MalekAlbdoor/UNCC_ROCKETRY_PAYLOAD_FALL_2026/PARTS_LIST.txt

================================================================================
TRANSONIC AVIONICS PAYLOAD - MAIN ICs & SENSORS  (rev B, 2026-10-20)
================================================================================

1. CORE LOGIC & MEMORY
--------------------------------------------------------------------------------
- Microcontroller:       STM32F405RGT6 (LQFP-64, Cortex-M4 @ 168 MHz)
- Flash:                 Winbond W25Q512JVFIQ (64 MB NOR, SOIC-16 300mil)

2. SENSORS
--------------------------------------------------------------------------------
- 6-DOF IMU:             STMicroelectronics LSM6DSO32TR (±32g / ±2000 dps, LGA-14)
- High-G Accelerometer:  STMicroelectronics H3LIS331DLTR (±100/200/400g, LGA-16)
- Barometer:             TE MS561101BA03-50 (24-bit, 8-SMD)
- GPS:                   u-blox SAM-M10Q-00B (integrated antenna, LGA-20)
- Air Temp / Humidity:   Sensirion SHT45-AD1F-R2 (PTFE membrane, DFN-4)

3. TELEMETRY
--------------------------------------------------------------------------------
- Radio:                 CDEBYTE E22-900M30S (SX1262 + PA, 915 MHz, 1W)

4. CAMERA
--------------------------------------------------------------------------------
- Camera:                RunCam Split 4 V3 (4K30, 5V rail, 450 mA max, UART control)

5. POWER
--------------------------------------------------------------------------------
- 5V Buck:               TI TPS54302DDCR (3A, SOT-23-6)
- 3.3V LDO:              Diodes Inc AP2112K-3.3TRG1 (600 mA, SOT-23-5)
================================================================================
