MalekAlbdoor/UNCC_ROCKETRY_PAYLOAD_FALL_2026/Schematic.pdf

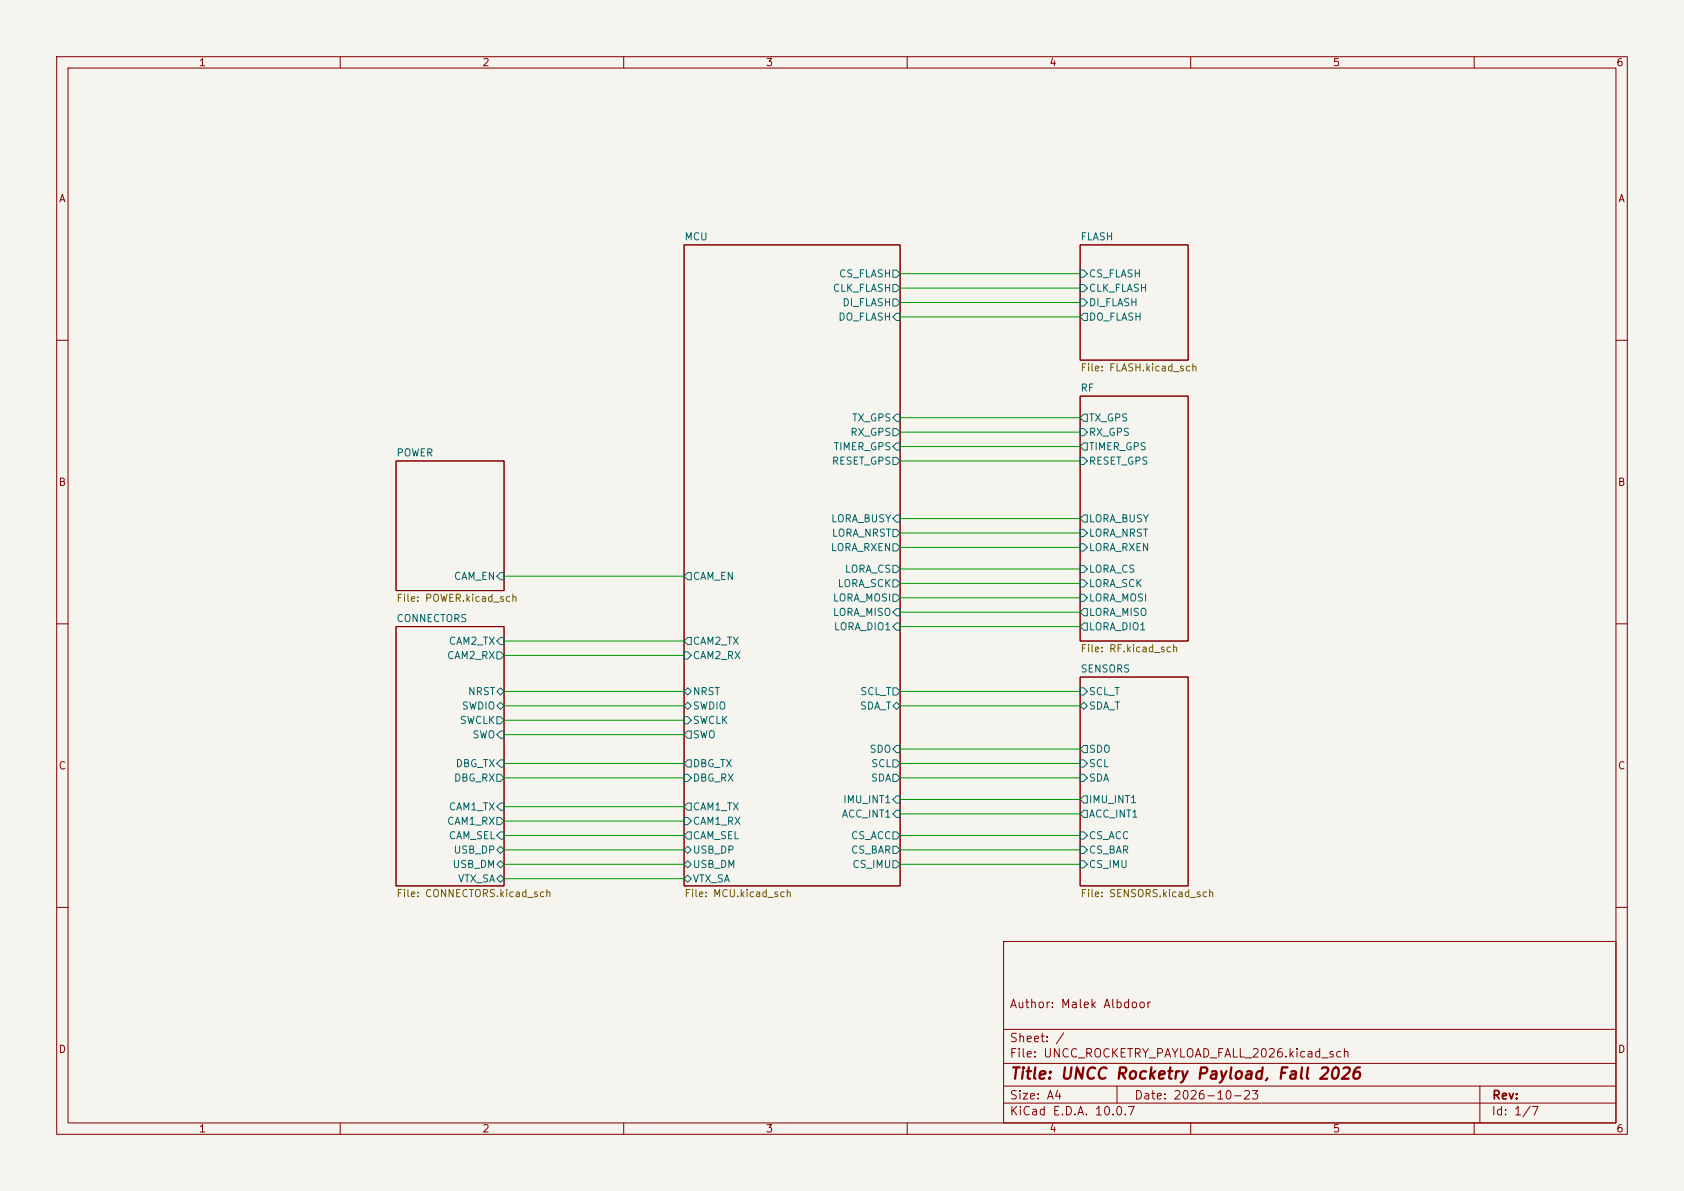
[picture p1: page 1]

File: RF.kicad_sch SCL SDA

File: MCU.kicad_sch NRST SWDIO

Sheet: /
File: UNCC_ROCKETRY_PAYLOAD_FALL_2026.kicad_sch
Title: UNCC Rocketry Payload, Fall 2026

Size: A4 | Rev:
KiCad E.D.A. 10.0.7 | Id: 1/7

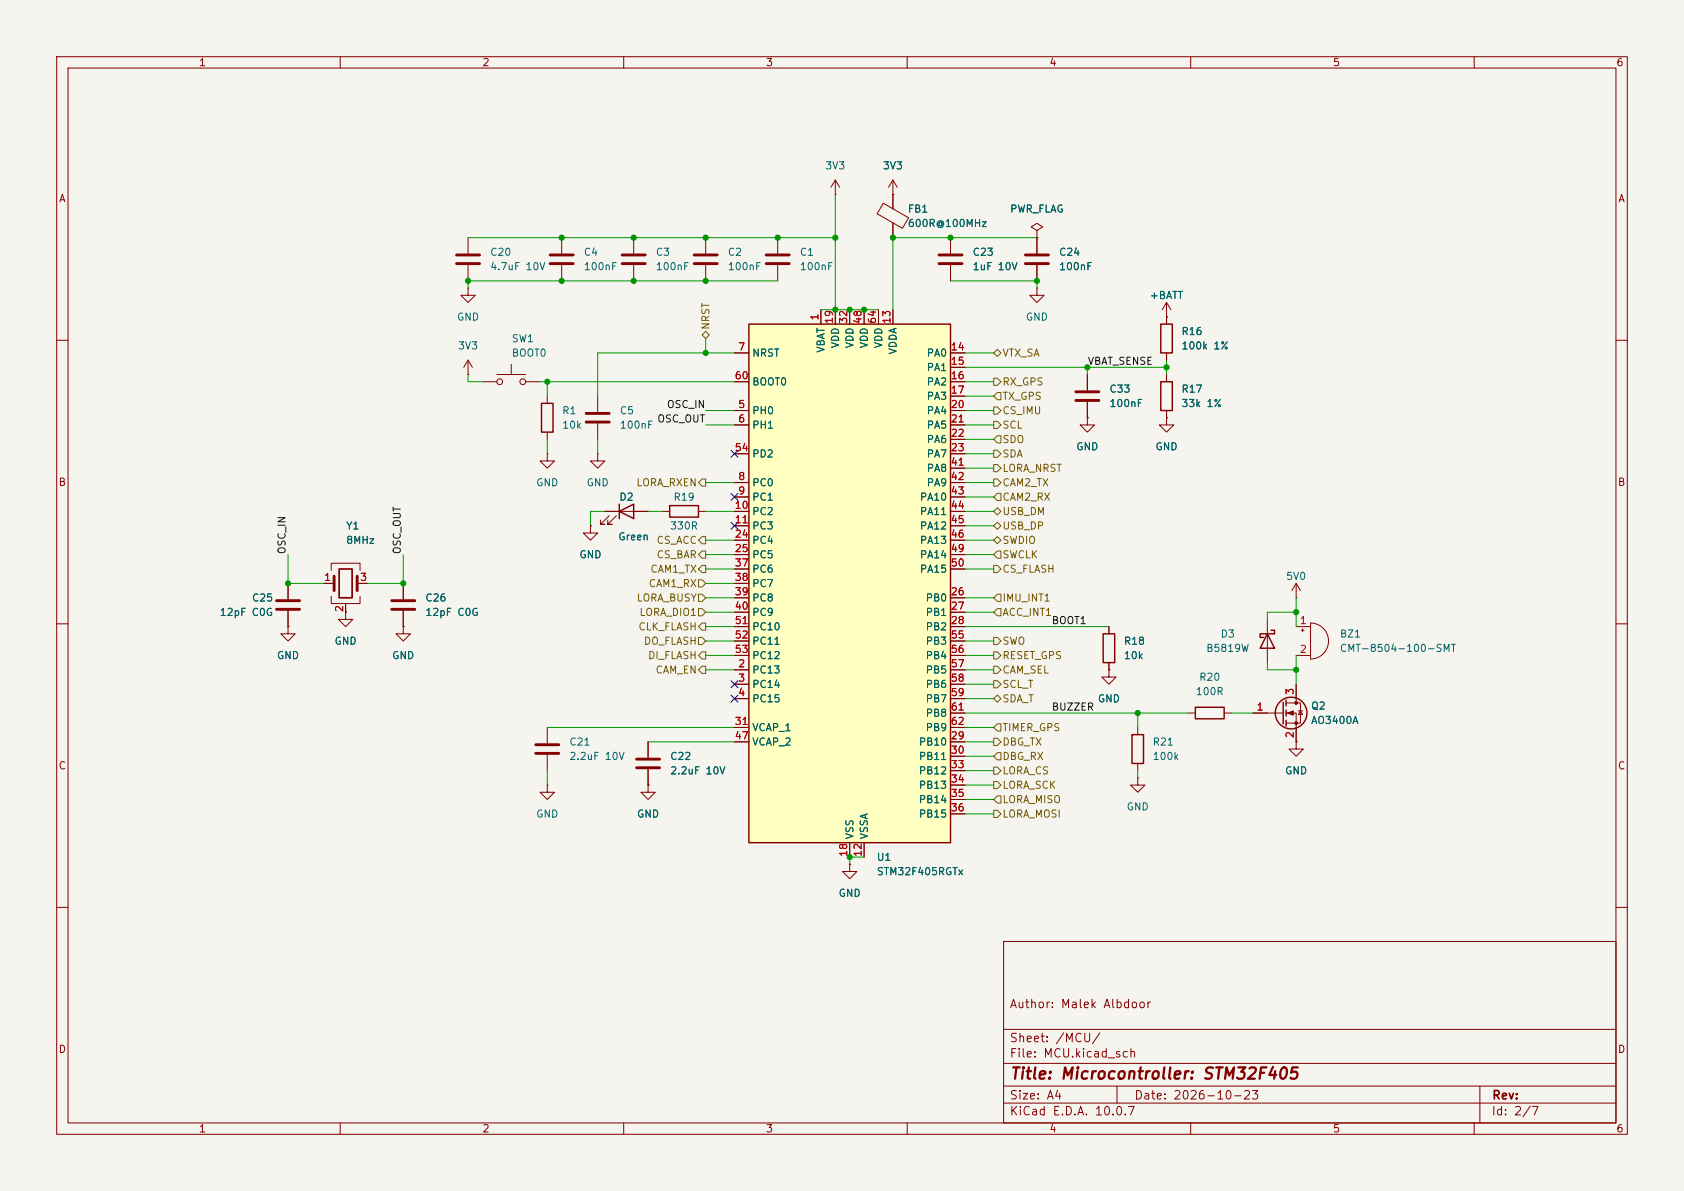
[picture p2: page 2]

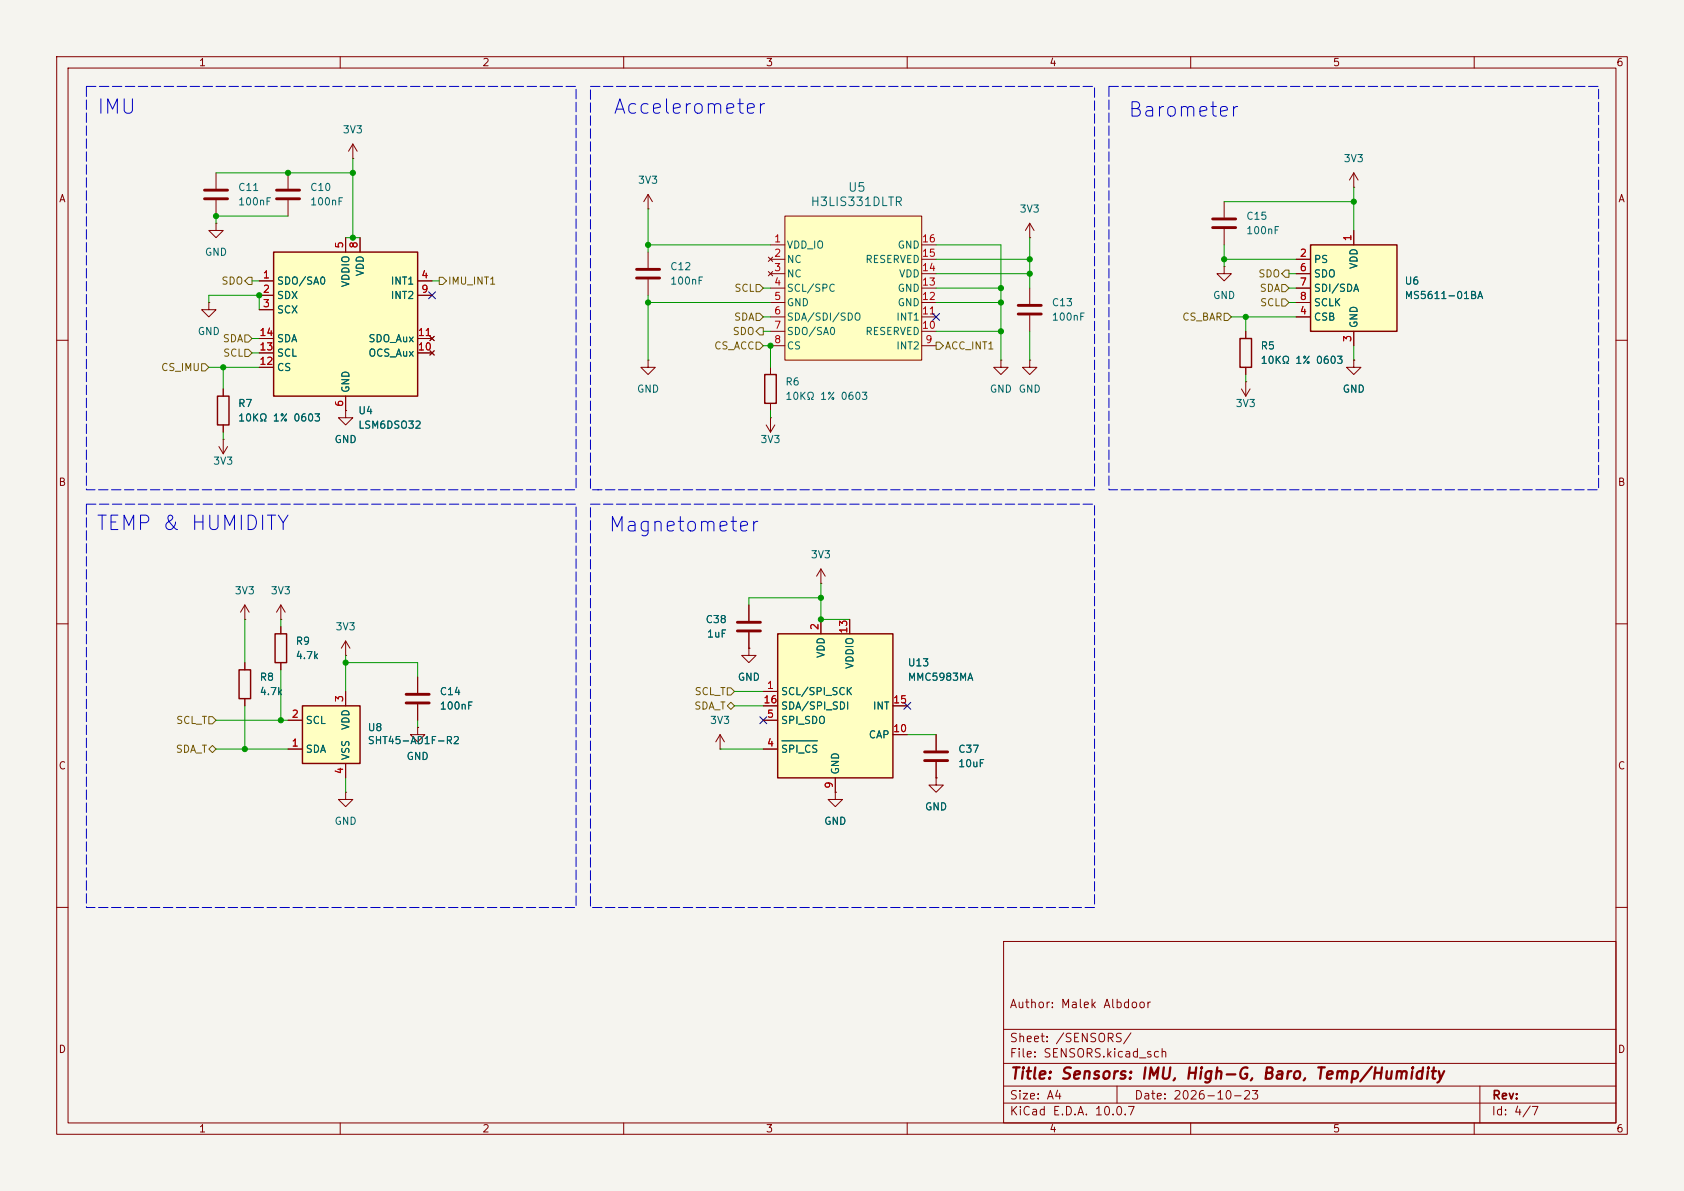
[picture p3: page 3]

Author: Malek Albdoor GND

Sheet: /SENSORS/
File: SENSORS.kicad_sch
Title: Sensors: IMU, High-G, Baro, Temp/Humidity

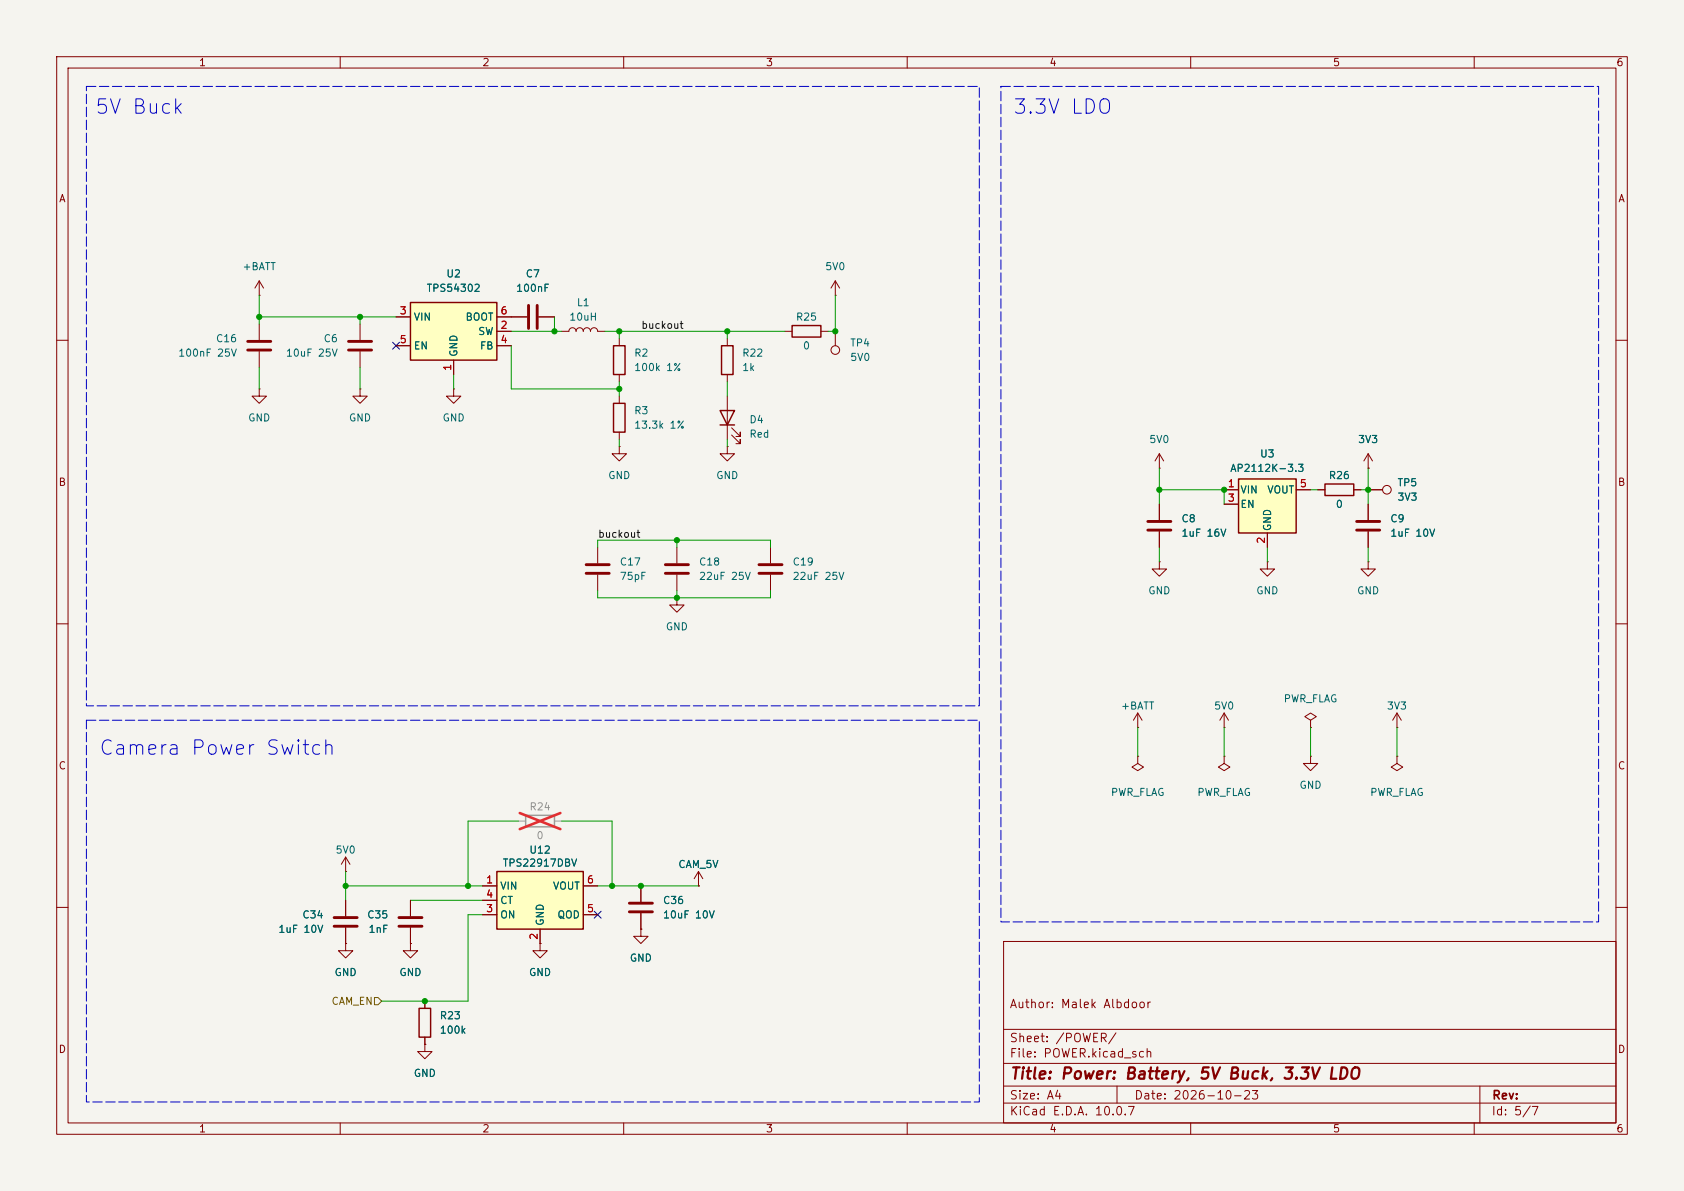
[picture p4: page 4]

Sheet: /POWER/
File: POWER.kicad_sch
Title: Power: Battery, 5V Buck, 3.3V LDO

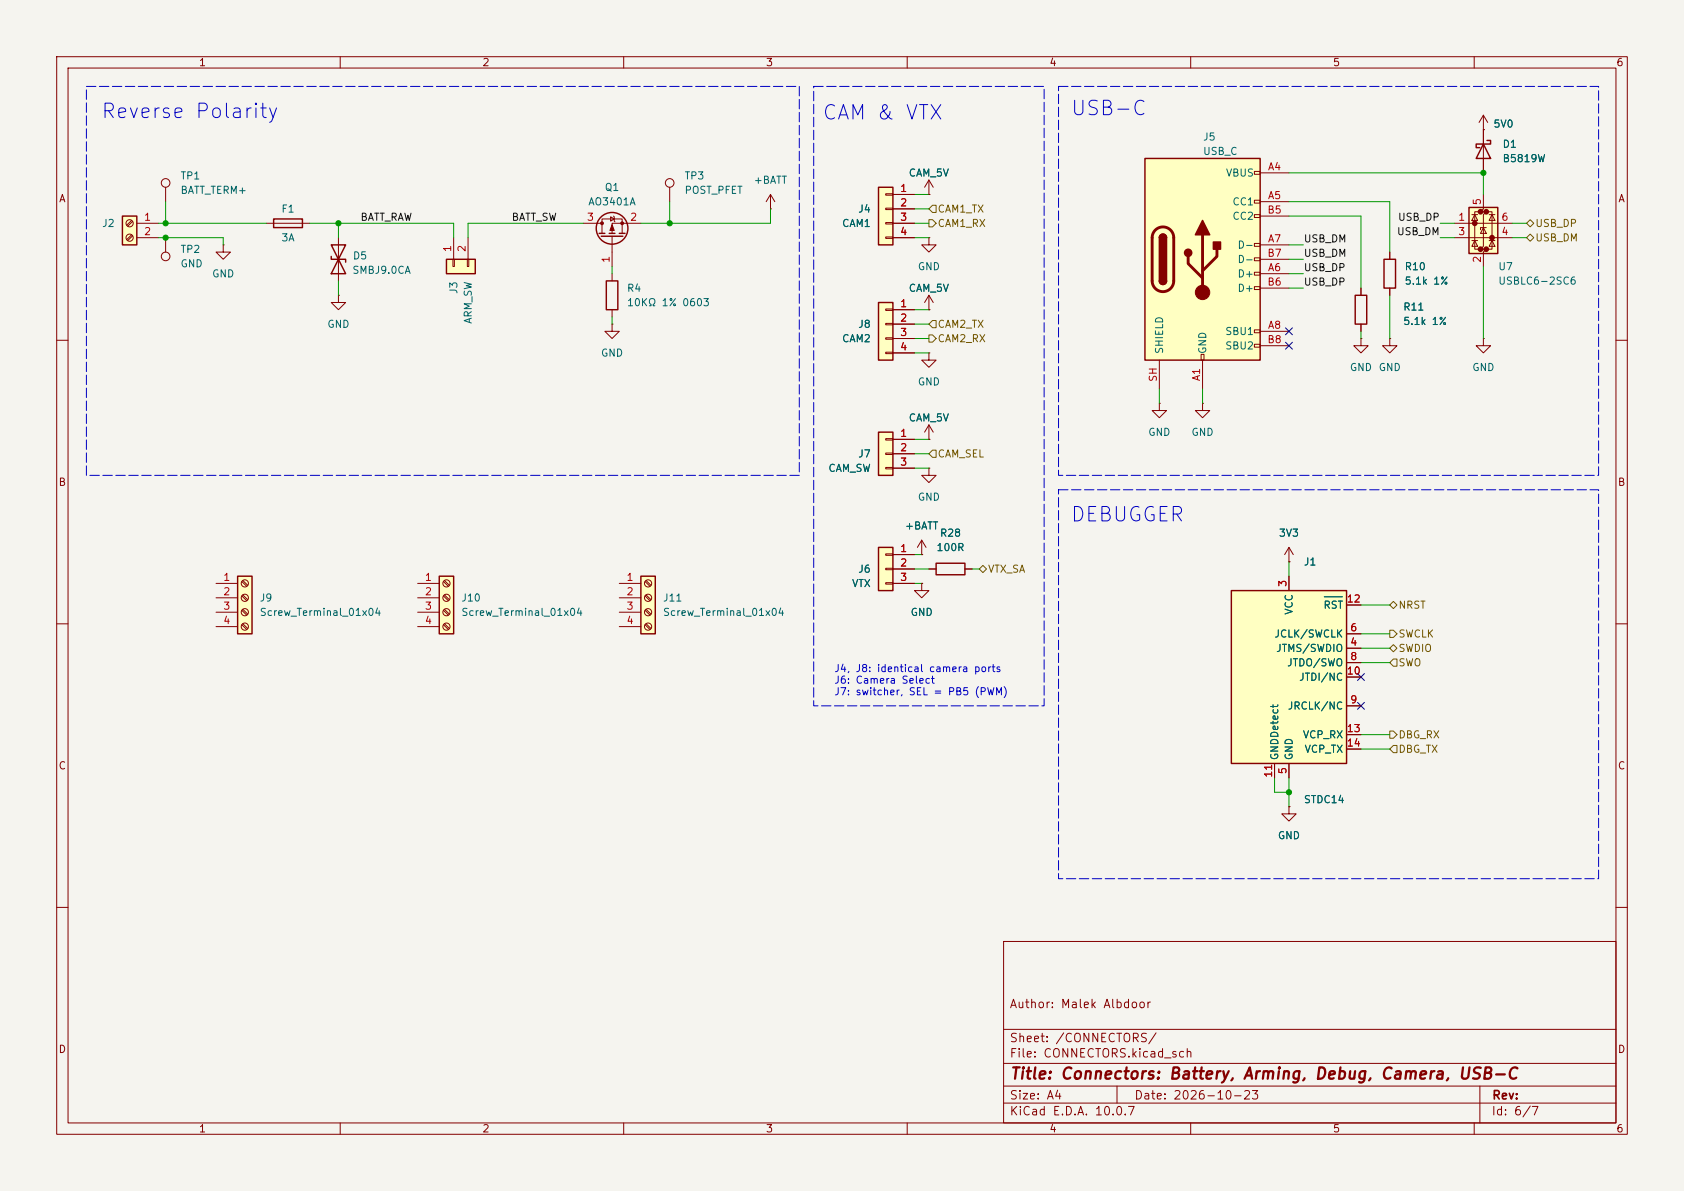
[picture p5: page 5]

J4, J8: identical camera ports
J6: Camera Select J7: switcher, SEL = PB5 (PWM)

Sheet: /CONNECTORS/
File: CONNECTORS.kicad_sch
Title: Connectors: Battery, Arming, Debug, Camera, USB-C

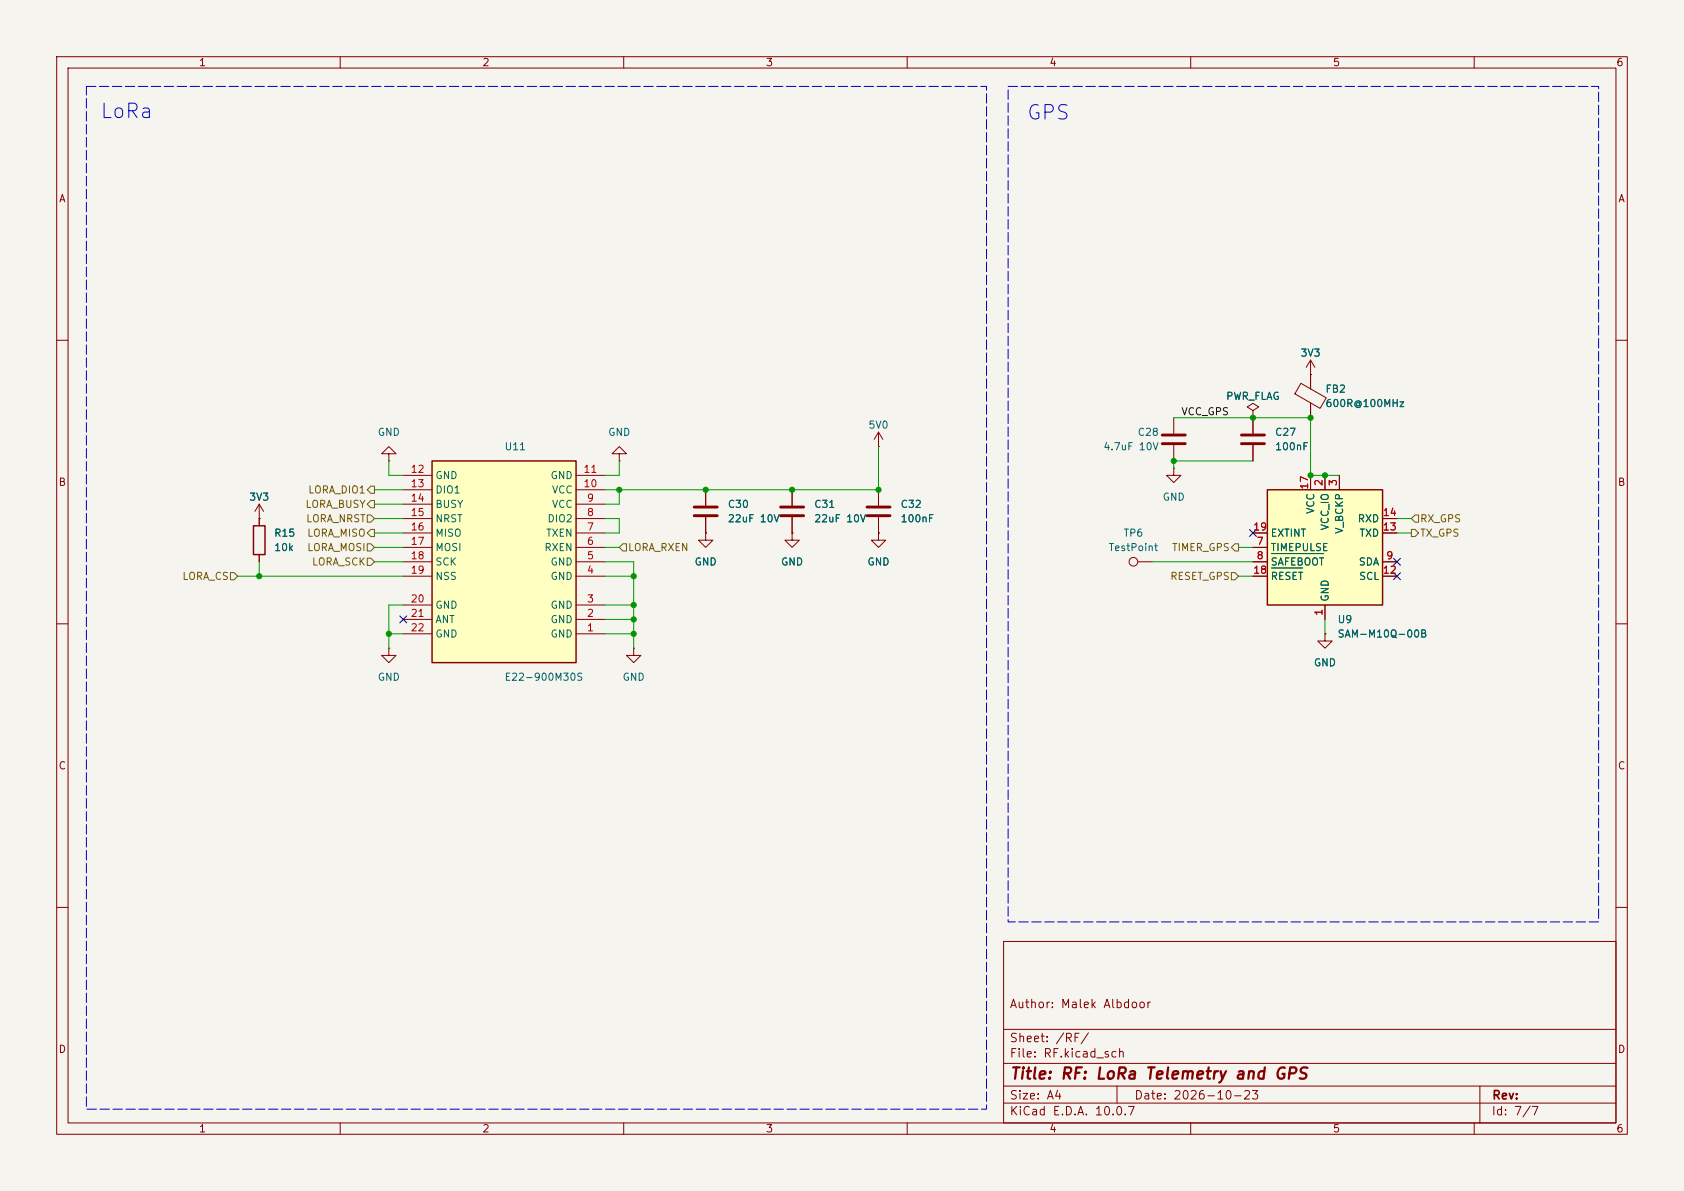
[picture p6: page 6]

Sheet: /RF/
File: RF.kicad_sch
Title: RF: LoRa Telemetry and GPS

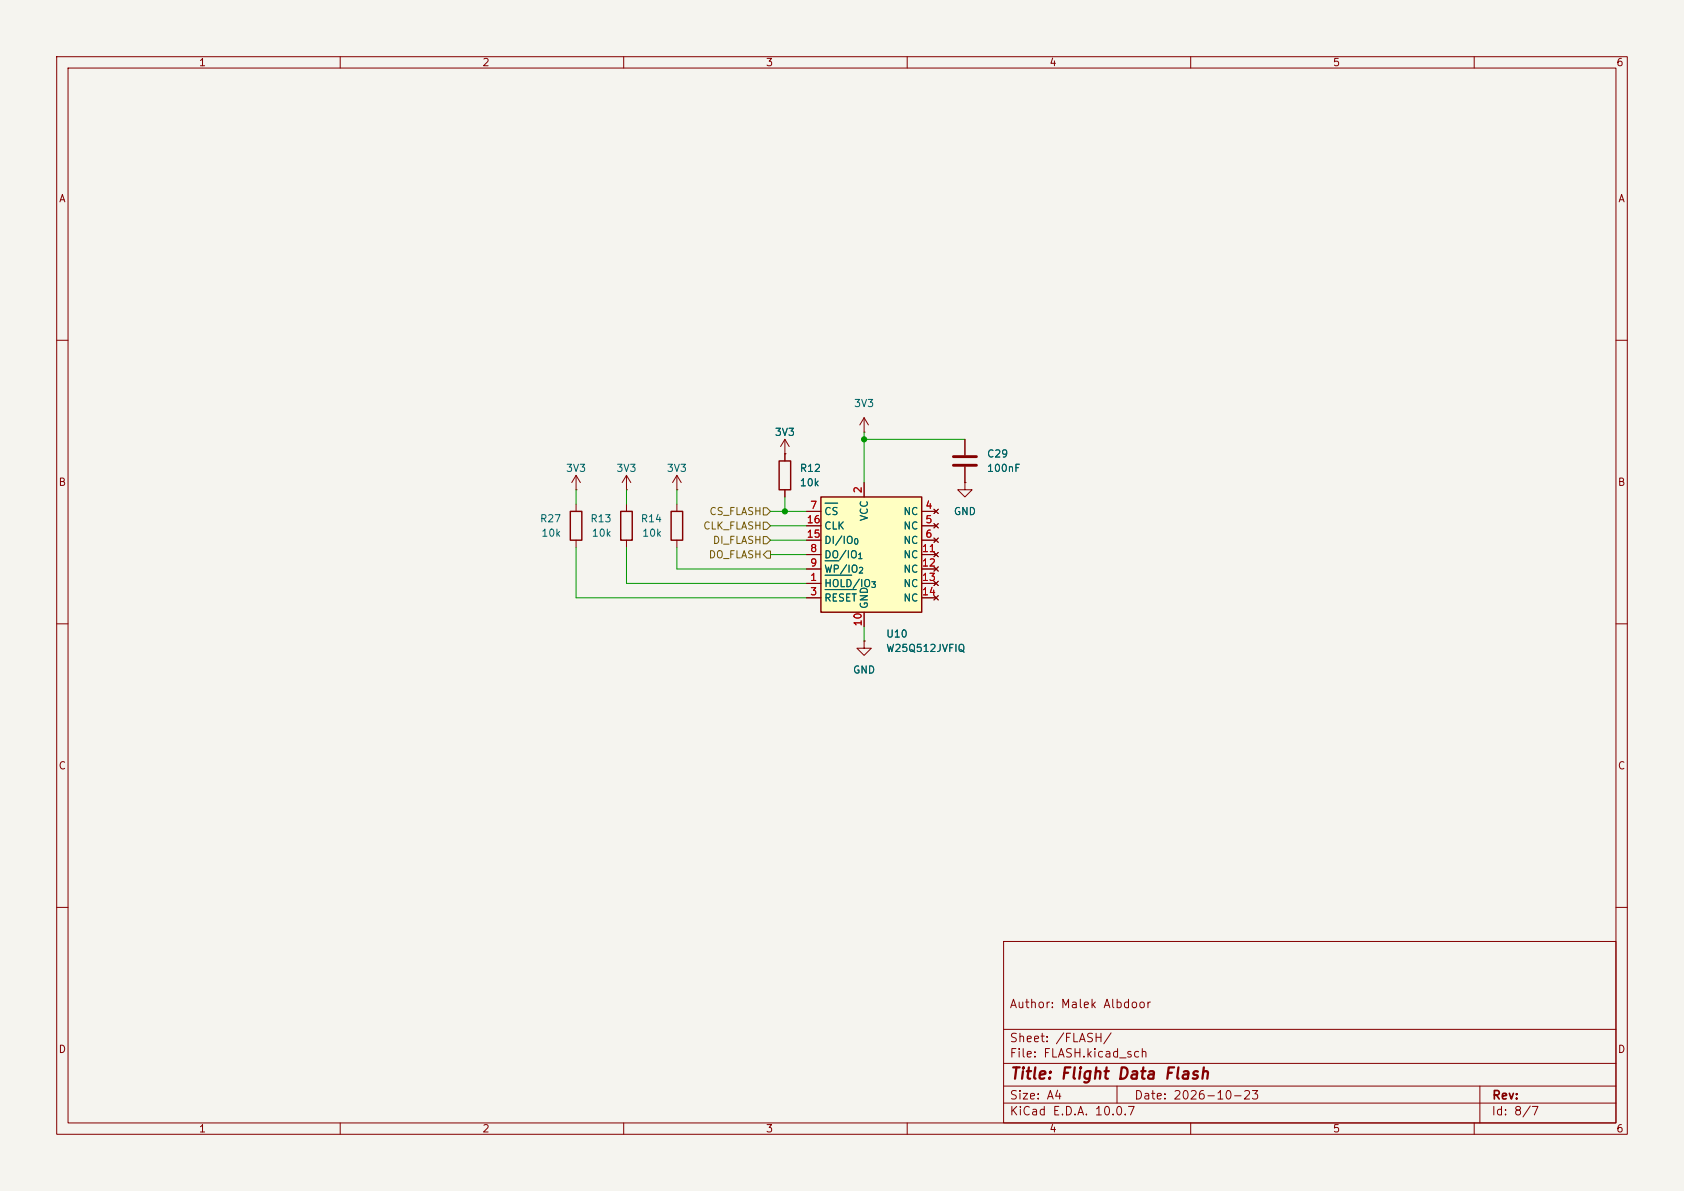
[picture p7: page 7]

Author: Malek Albdoor GND

2 RESET 3 NC 4 NC 5 NC 6 CS 7 DO/IO1 8 WP/IO2 9 GND 10 NC 11 NC 12 NC 13 NC 14 DI/IO0 15 CLK 16 U10 W25Q512JVFIQ

2 RESET 3 NC 4 NC 5 NC 6 CS 7 DO/IO1 8 WP/IO2 9 GND 10 NC 11 NC 12 NC 13 NC 14 DI/IO0 15 CLK 16 GND

Sheet: /FLASH/
File: FLASH.kicad_sch
Title: Flight Data Flash
