MalekAlbdoor/UNCC_ROCKETRY_PAYLOAD_FALL_2026/UNCC_ROCKETRY_PAYLOAD_FALL_2026.kicad_pcb

## KiCad design UNCC_ROCKETRY_PAYLOAD_FALL_2026.kicad_pcb (2026-11-13)

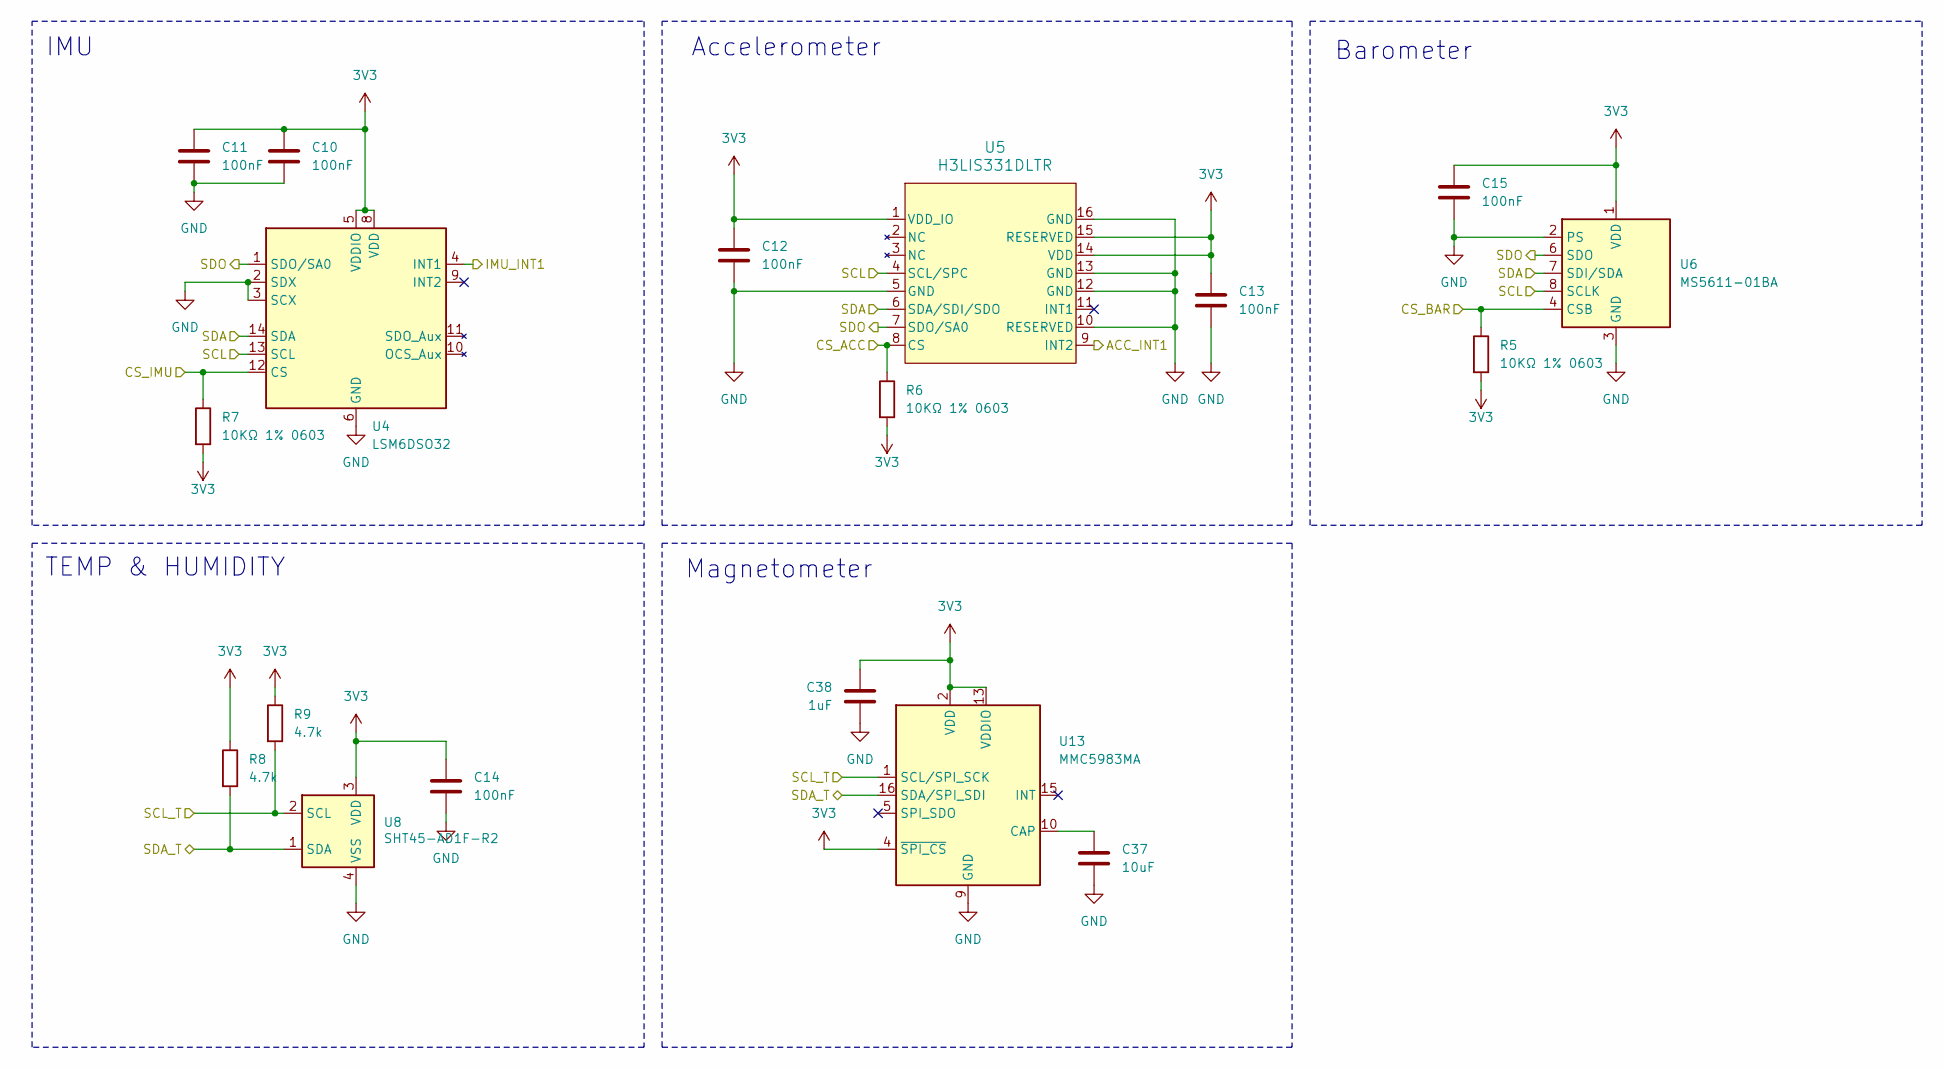
[picture p8: schematic SENSORS.kicad_sch, Sensors: IMU, High-G, Baro, Temp/Humidity]

Parts:
C10, C11, C12, C13, C14, C15: 100nF; C_0603_1608Metric_Pad1.08x0.95mm_HandSolder
C37: 10uF; C_0805_2012Metric_Pad1.18x1.45mm_HandSolder
C38: 1uF; C_0603_1608Metric_Pad1.08x0.95mm_HandSolder
R5, R6, R7: 10KΩ 1% 0603; R_0603_1608Metric_Pad0.98x0.95mm_HandSolder
R8, R9: 4.7k; R_0603_1608Metric_Pad0.98x0.95mm_HandSolder
U4: LSM6DSO32; LGA-14_3x2.5mm_P0.5mm_LayoutBorder3x4y
U5: H3LIS331DLTR; LGA-16_3x3mm_P0.5mm_LayoutBorder3x5y
U6: MS5611-01BA; LGA-8_3x5mm_P1.25mm
U8: SHT45-AD1F-R2; Sensirion_DFN-4_1.5x1.5mm_P0.8mm_SHT4x_NoCentralPad
U13: MMC5983MA; LGA-16_3x3mm_P0.5mm

Connections:
3V3: C10.1, C11.1, C12.1, C13.1, C14.1, C15.1, C38.1, R5.2, R6.2, R7.2, R8.1, R9.1, U4.5 (VDDIO), U4.8 (VDD), U5.1 (VDD_IO), U5.14 (VDD), U5.15 (RESERVED), U6.1 (VDD), U8.3 (VDD), U13.2 (VDD), U13.4 (~SPI_CS), U13.13 (VDDIO); also elsewhere on the board
/MCU/ACC_INT1: U5.9 (INT2); also elsewhere on the board
/MCU/CS_ACC: R6.1, U5.8 (CS); also elsewhere on the board
/MCU/CS_BAR: R5.1, U6.4 (CSB), U6.5 (CSB); also elsewhere on the board
/MCU/CS_IMU: R7.1, U4.12 (CS); also elsewhere on the board
/MCU/IMU_INT1: U4.4 (INT1); also elsewhere on the board
/MCU/SCL: U4.13 (SCL), U5.4 (SCL/SPC), U6.8 (SCLK); also elsewhere on the board
/MCU/SDA: U4.14 (SDA), U5.6 (SDA/SDI/SDO), U6.7 (SDI/SDA); also elsewhere on the board
/MCU/SDO: U4.1 (SDO/SA0), U5.7 (SDO/SA0), U6.6 (SDO); also elsewhere on the board
/SCL_T: R9.2, U8.2 (SCL), U13.1 (SCL/SPI_SCK); also elsewhere on the board
/SDA_T: R8.2, U8.1 (SDA), U13.16 (SDA/SPI_SDI); also elsewhere on the board
GND: C10.2, C11.2, C12.2, C13.2, C14.2, C15.2, C37.2, C38.2, U4.2 (SDX), U4.3 (SCX), U4.6 (GND), U4.7 (GND), U5.5 (GND), U5.10 (RESERVED), U5.12 (GND), U5.13 (GND), U5.16 (GND), U6.2 (PS), U6.3 (GND), U8.4 (VSS), U13.9 (GND), U13.11 (GND); also elsewhere on the board
unnamed: C37.1, U13.10 (CAP)

Notes on the sheet:
Magnetometer
TEMP & HUMIDITY
Barometer
Accelerometer
IMU

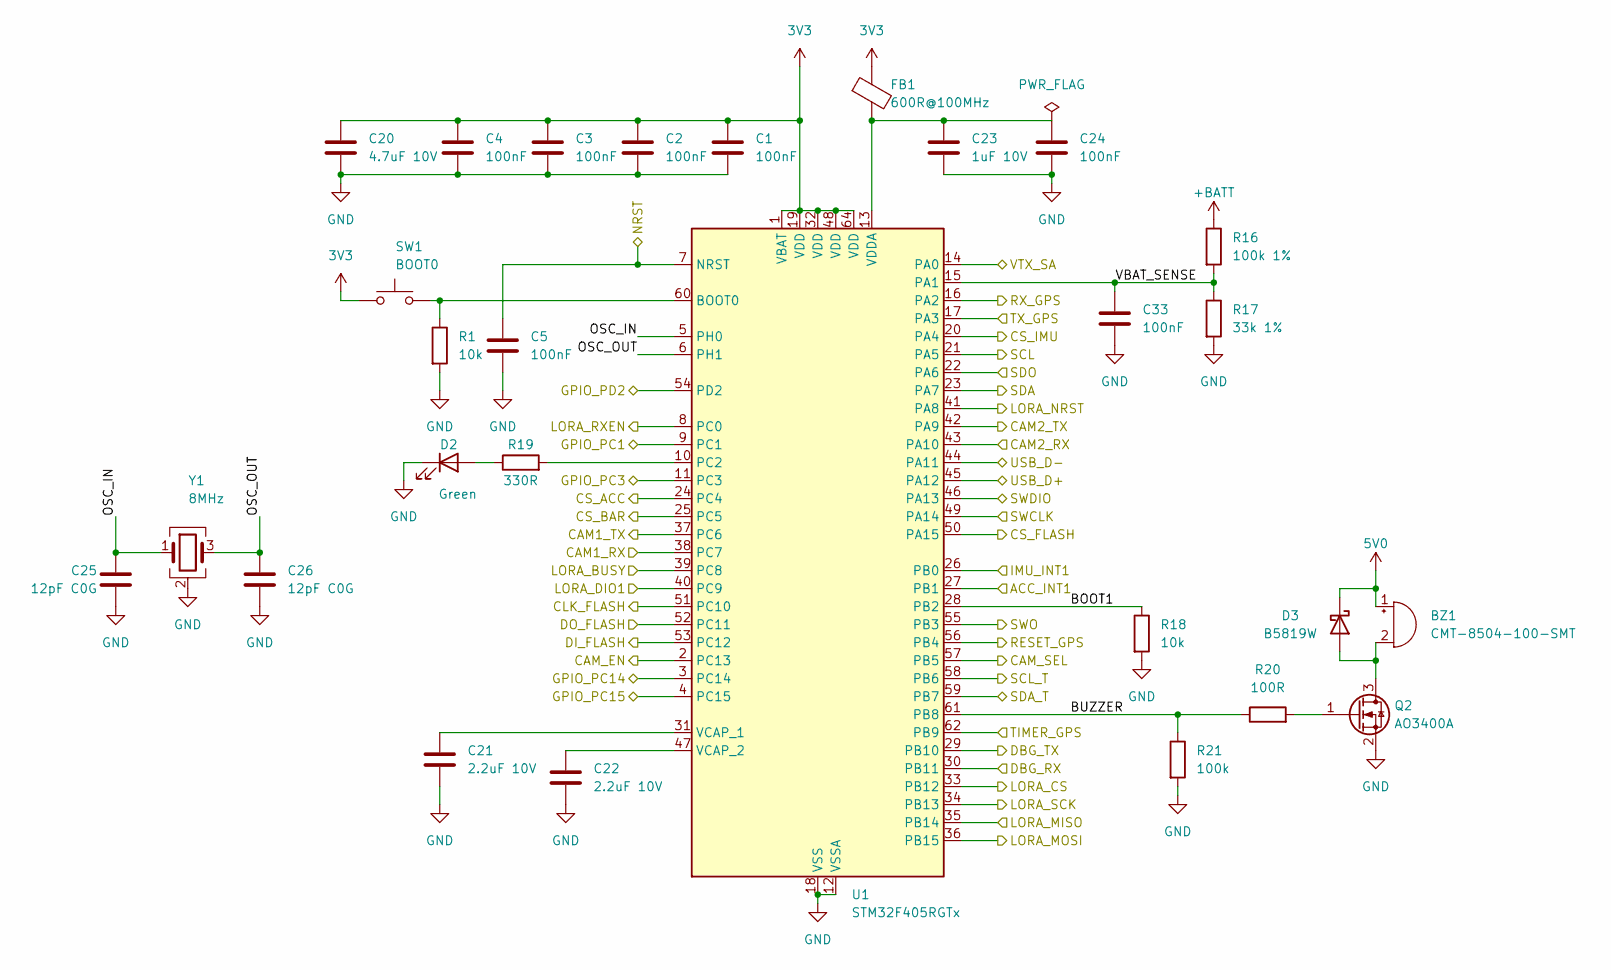
[picture p9: schematic MCU.kicad_sch, Microcontroller: STM32F405]

Parts:
BZ1: CMT-8504-100-SMT; MagneticBuzzer_CUI_CMT-8504-100-SMT
C1, C2, C3, C4, C5, C24, C33: 100nF; C_0603_1608Metric_Pad1.08x0.95mm_HandSolder
C20: 4.7uF 10V; C_0603_1608Metric_Pad1.08x0.95mm_HandSolder
C21, C22: 2.2uF 10V; C_0603_1608Metric_Pad1.08x0.95mm_HandSolder
C23: 1uF 10V; C_0603_1608Metric_Pad1.08x0.95mm_HandSolder
C25, C26: 12pF C0G; C_0603_1608Metric_Pad1.08x0.95mm_HandSolder
D2: Green; LED_0603_1608Metric_Pad1.05x0.95mm_HandSolder
D3: B5819W; D_SOD-123
FB1: 600R@100MHz; L_0603_1608Metric_Pad1.05x0.95mm_HandSolder
Q2: AO3400A; SOT-23
R1, R18: 10k; R_0603_1608Metric_Pad0.98x0.95mm_HandSolder
R16: 100k 1%; R_0603_1608Metric_Pad0.98x0.95mm_HandSolder
R17: 33k 1%; R_0603_1608Metric_Pad0.98x0.95mm_HandSolder
R19: 330R; R_0603_1608Metric_Pad0.98x0.95mm_HandSolder
R20: 100R; R_0603_1608Metric_Pad0.98x0.95mm_HandSolder
R21: 100k; R_0603_1608Metric_Pad0.98x0.95mm_HandSolder
SW1: BOOT0; SW_SPST_TL3342
U1: STM32F405RGTx; LQFP-64_10x10mm_P0.5mm
Y1: 8MHz; Crystal_SMD_Abracon_ABM3B-4Pin_5.0x3.2mm; MPN ABM3B-8.000MHZ-10-D-1-G-T

Connections:
3V3: C1.1, C2.1, C3.1, C4.1, C20.1, FB1.1, SW1.1, U1.1 (VBAT), U1.19 (VDD), U1.32 (VDD), U1.48 (VDD), U1.64 (VDD); also elsewhere on the board
5V0: BZ1.1 (+), D3.1 (K); also elsewhere on the board
+BATT: R16.1; also elsewhere on the board
/CONNECTORS/CAM1_RX: U1.38 (PC7); also elsewhere on the board
/CONNECTORS/CAM1_TX: U1.37 (PC6); also elsewhere on the board
/CONNECTORS/CAM2_RX: U1.43 (PA10); also elsewhere on the board
/CONNECTORS/CAM2_TX: U1.42 (PA9); also elsewhere on the board
/CONNECTORS/CAM_SEL: U1.57 (PB5); also elsewhere on the board
/CONNECTORS/DBG_RX: U1.30 (PB11); also elsewhere on the board
/CONNECTORS/DBG_TX: U1.29 (PB10); also elsewhere on the board
/CONNECTORS/GPIO_PC1: U1.9 (PC1); also elsewhere on the board
/CONNECTORS/GPIO_PC3: U1.11 (PC3); also elsewhere on the board
/CONNECTORS/GPIO_PC14: U1.3 (PC14); also elsewhere on the board
/CONNECTORS/GPIO_PC15: U1.4 (PC15); also elsewhere on the board
/CONNECTORS/NRST: C5.1, U1.7 (NRST); also elsewhere on the board
/CONNECTORS/SWCLK: U1.49 (PA14); also elsewhere on the board
/CONNECTORS/SWDIO: U1.46 (PA13); also elsewhere on the board
/CONNECTORS/SWO: U1.55 (PB3); also elsewhere on the board
/CONNECTORS/USB_D+: U1.45 (PA12); also elsewhere on the board
/CONNECTORS/USB_D-: U1.44 (PA11); also elsewhere on the board
/CONNECTORS/VTX_SA: U1.14 (PA0); also elsewhere on the board
/FLASH/CLK_FLASH: U1.51 (PC10); also elsewhere on the board
/FLASH/CS_FLASH: U1.50 (PA15); also elsewhere on the board
/FLASH/DI_FLASH: U1.53 (PC12); also elsewhere on the board
/FLASH/DO_FLASH: U1.52 (PC11); also elsewhere on the board
/MCU/ACC_INT1: U1.27 (PB1); also elsewhere on the board
/MCU/BOOT1: R18.1, U1.28 (PB2)
/MCU/BUZZER: R20.1, R21.1, U1.61 (PB8)
/MCU/CAM_EN: U1.2 (PC13); also elsewhere on the board
/MCU/CS_ACC: U1.24 (PC4); also elsewhere on the board
/MCU/CS_BAR: U1.25 (PC5); also elsewhere on the board
/MCU/CS_IMU: U1.20 (PA4); also elsewhere on the board
/MCU/GPIO_PD2: U1.54 (PD2)
/MCU/IMU_INT1: U1.26 (PB0); also elsewhere on the board
/MCU/LORA_BUSY: U1.39 (PC8); also elsewhere on the board
/MCU/LORA_CS: U1.33 (PB12); also elsewhere on the board
/MCU/LORA_DIO1: U1.40 (PC9); also elsewhere on the board
/MCU/LORA_MISO: U1.35 (PB14); also elsewhere on the board
/MCU/LORA_MOSI: U1.36 (PB15); also elsewhere on the board
/MCU/LORA_NRST: U1.41 (PA8); also elsewhere on the board
/MCU/LORA_RXEN: U1.8 (PC0); also elsewhere on the board
/MCU/LORA_SCK: U1.34 (PB13); also elsewhere on the board
/MCU/OSC_IN: C25.1, U1.5 (PH0), Y1.1
/MCU/OSC_OUT: C26.1, U1.6 (PH1), Y1.3
/MCU/RESET_GPS: U1.56 (PB4); also elsewhere on the board
/MCU/RX_GPS: U1.16 (PA2); also elsewhere on the board
/MCU/SCL: U1.21 (PA5); also elsewhere on the board
/MCU/SDA: U1.23 (PA7); also elsewhere on the board
/MCU/SDO: U1.22 (PA6); also elsewhere on the board
/MCU/TIMER_GPS: U1.62 (PB9); also elsewhere on the board
/MCU/TX_GPS: U1.17 (PA3); also elsewhere on the board
/MCU/VBAT_SENSE: C33.1, R16.2, R17.1, U1.15 (PA1)
/SCL_T: U1.58 (PB6); also elsewhere on the board
/SDA_T: U1.59 (PB7); also elsewhere on the board
GND: C1.2, C2.2, C3.2, C4.2, C5.2, C20.2, C21.2, C22.2, C23.2, C24.2, C25.2, C26.2, C33.2, D2.1 (K), Q2.2 (S), R1.2, R17.2, R18.2, R21.2, U1.12 (VSSA), U1.18 (VSS), U1.63 (VSS), Y1.2 (G), Y1.4 (G); also elsewhere on the board
unnamed: BZ1.2 (-), D3.2 (A), Q2.3 (D)
unnamed: D2.2 (A), R19.1
unnamed: Q2.1 (G), R20.2
unnamed: R1.1, SW1.2, U1.60 (BOOT0)
unnamed: R19.2, U1.10 (PC2)
unnamed: C21.1, U1.31 (VCAP_1)
unnamed: C22.1, U1.47 (VCAP_2)
unnamed: C23.1, C24.1, FB1.2, U1.13 (VDDA)

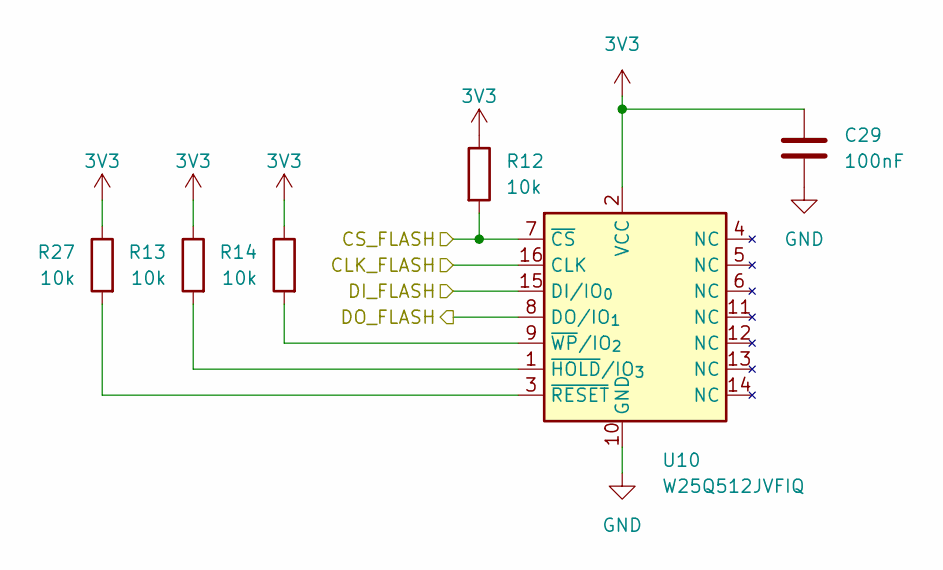
[picture p10: schematic FLASH.kicad_sch, Flight Data Flash]

Parts:
C29: 100nF; C_0603_1608Metric_Pad1.08x0.95mm_HandSolder
R12, R13, R14, R27: 10k; R_0603_1608Metric_Pad0.98x0.95mm_HandSolder
U10: W25Q512JVFIQ; SOIC-16W_7.5x10.3mm_P1.27mm

Connections:
3V3: C29.1, R12.1, R13.1, R14.1, R27.1, U10.2 (VCC); also elsewhere on the board
/FLASH/CLK_FLASH: U10.16 (CLK); also elsewhere on the board
/FLASH/CS_FLASH: R12.2, U10.7 (~CS); also elsewhere on the board
/FLASH/DI_FLASH: U10.15 (DI/IO_{0}); also elsewhere on the board
/FLASH/DO_FLASH: U10.8 (DO/IO_{1}); also elsewhere on the board
GND: C29.2, U10.10 (GND); also elsewhere on the board
unnamed: R13.2, U10.1 (~HOLD/IO_{3})
unnamed: R27.2, U10.3 (~RESET)
unnamed: R14.2, U10.9 (~WP/IO_{2})

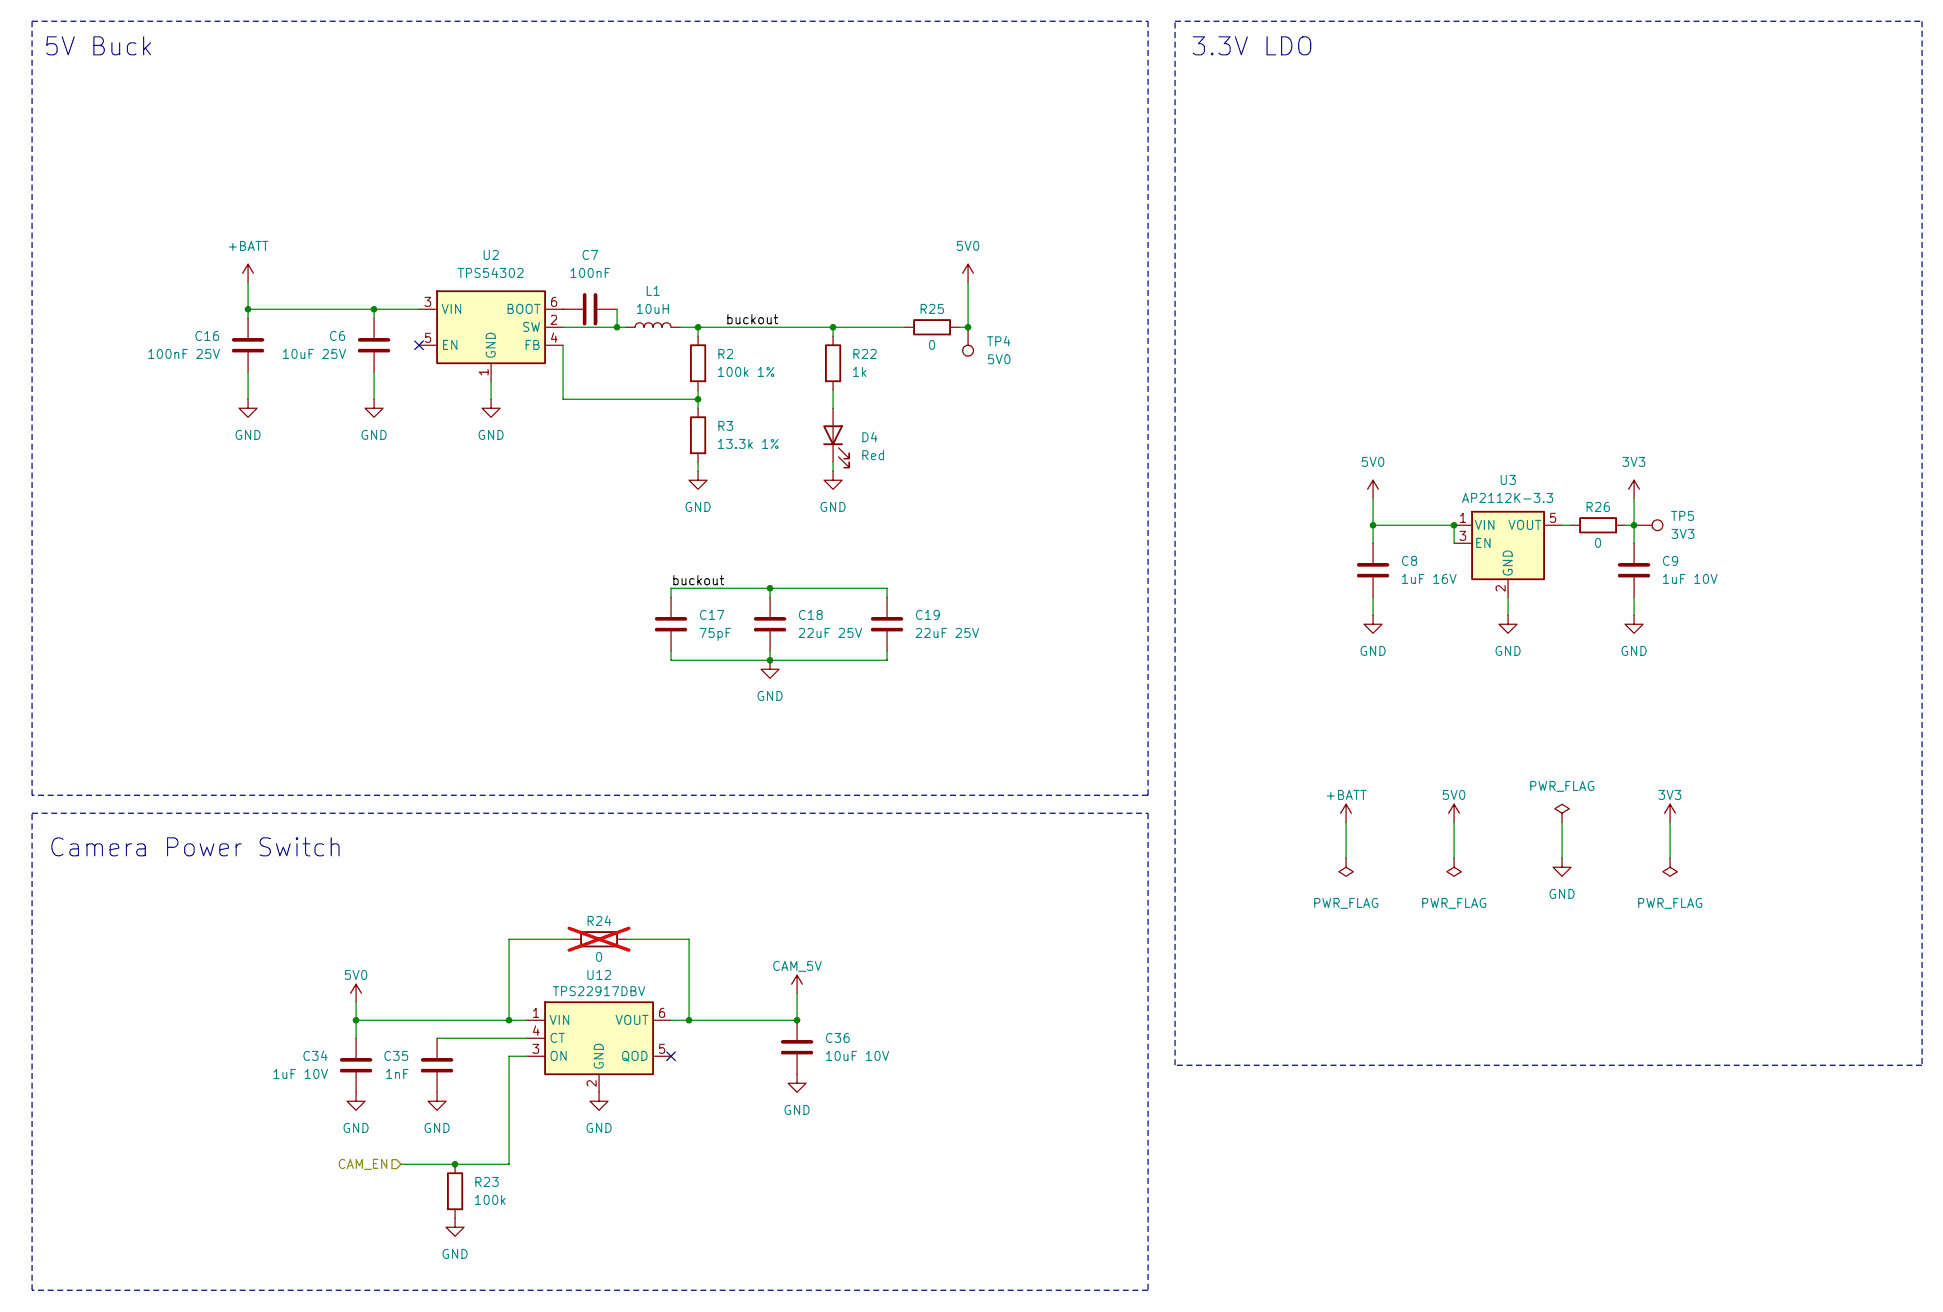
[picture p11: schematic POWER.kicad_sch, Power: Battery, 5V Buck, 3.3V LDO]

Parts:
C6: 10uF 25V; C_1206_3216Metric_Pad1.33x1.80mm_HandSolder
C7: 100nF; C_0603_1608Metric_Pad1.08x0.95mm_HandSolder
C8: 1uF 16V; C_0603_1608Metric_Pad1.08x0.95mm_HandSolder
C9, C34: 1uF 10V; C_0603_1608Metric_Pad1.08x0.95mm_HandSolder
C16: 100nF 25V; C_0603_1608Metric_Pad1.08x0.95mm_HandSolder
C17: 75pF; C_0603_1608Metric_Pad1.08x0.95mm_HandSolder
C18, C19: 22uF 25V; C_1206_3216Metric_Pad1.33x1.80mm_HandSolder
C35: 1nF; C_0603_1608Metric_Pad1.08x0.95mm_HandSolder
C36: 10uF 10V; C_0805_2012Metric_Pad1.18x1.45mm_HandSolder
D4: Red; LED_0603_1608Metric_Pad1.05x0.95mm_HandSolder
L1: 10uH; L_Wuerth_XHMI-6060; MPN 74439346100
R2: 100k 1%; R_0603_1608Metric_Pad0.98x0.95mm_HandSolder
R3: 13.3k 1%; R_0603_1608Metric_Pad0.98x0.95mm_HandSolder
R22: 1k; R_0603_1608Metric_Pad0.98x0.95mm_HandSolder
R23: 100k; R_0603_1608Metric_Pad0.98x0.95mm_HandSolder
R24: 0; R_0603_1608Metric_Pad0.98x0.95mm_HandSolder; not fitted
R25, R26: 0; R_0603_1608Metric_Pad0.98x0.95mm_HandSolder
TP4: 5V0; TestPoint_Pad_D1.5mm
TP5: 3V3; TestPoint_Pad_D1.5mm
U2: TPS54302; SOT-23-6
U3: AP2112K-3.3; SOT-23-5
U12: TPS22917DBV; SOT-23-6

Connections:
3V3: C9.1, R26.2, TP5.1 (1_1); also elsewhere on the board
5V0: C8.1, C34.1, R24.1, R25.2, TP4.1 (1_1), U3.1 (VIN), U3.3 (EN), U12.1 (VIN); also elsewhere on the board
+BATT: C6.1, C16.1, U2.3 (VIN); also elsewhere on the board
/MCU/CAM_EN: R23.1, U12.3 (ON); also elsewhere on the board
/POWER/buckout: C17.1, C18.1, C19.1, L1.2, R2.1, R22.1, R25.1
CAM_5V: C36.1, R24.2, U12.6 (VOUT); also elsewhere on the board
GND: C6.2, C8.2, C9.2, C16.2, C17.2, C18.2, C19.2, C34.2, C35.2, C36.2, D4.1 (K), R3.2, R23.2, U2.1 (GND), U3.2 (GND), U12.2 (GND); also elsewhere on the board
unnamed: D4.2 (A), R22.2
unnamed: C7.1, U2.6 (BOOT)
unnamed: R2.2, R3.1, U2.4 (FB)
unnamed: C7.2, L1.1, U2.2 (SW)
unnamed: R26.1, U3.5 (VOUT)
unnamed: C35.1, U12.4 (CT)

Notes on the sheet:
3.3V LDO
5V Buck
Camera Power Switch

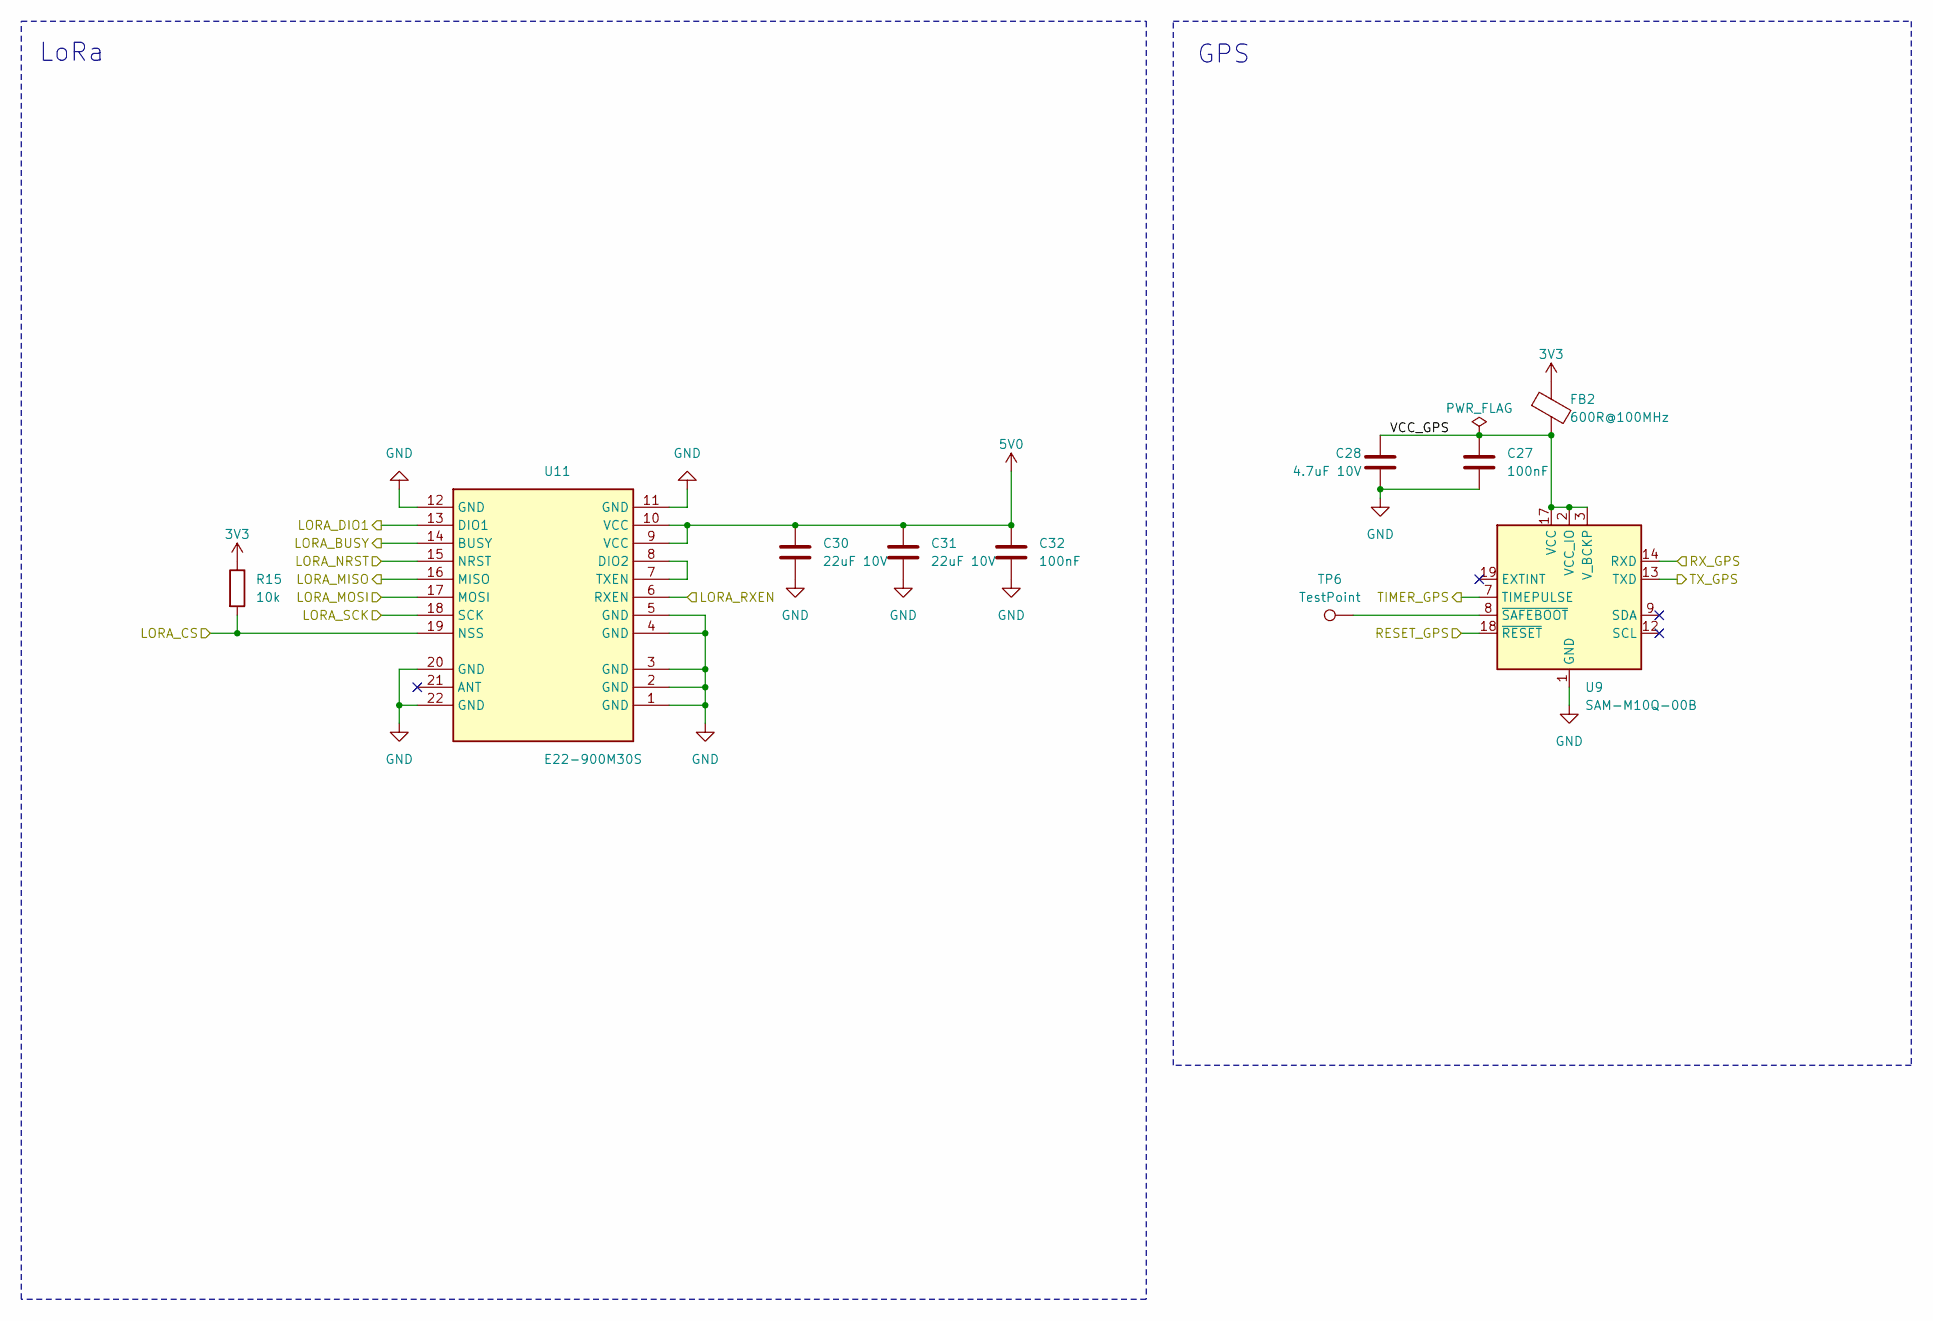
[picture p12: schematic RF.kicad_sch, RF: LoRa Telemetry and GPS]

Parts:
C27, C32: 100nF; C_0603_1608Metric_Pad1.08x0.95mm_HandSolder
C28: 4.7uF 10V; C_0603_1608Metric_Pad1.08x0.95mm_HandSolder
C30, C31: 22uF 10V; C_1206_3216Metric_Pad1.33x1.80mm_HandSolder
FB2: 600R@100MHz; L_0603_1608Metric_Pad1.05x0.95mm_HandSolder
R15: 10k; R_0603_1608Metric_Pad0.98x0.95mm_HandSolder
TP6: TestPoint; TestPoint_Pad_D1.5mm
U9: SAM-M10Q-00B; ublox_SAM-M8Q
U11: E22-900M30S; WIRELM-SMD_E22-900M30S

Connections:
3V3: FB2.1, R15.1; also elsewhere on the board
5V0: C30.1, C31.1, C32.1, U11.9 (VCC), U11.10 (VCC); also elsewhere on the board
/MCU/LORA_BUSY: U11.14 (BUSY); also elsewhere on the board
/MCU/LORA_CS: R15.2, U11.19 (NSS); also elsewhere on the board
/MCU/LORA_DIO1: U11.13 (DIO1); also elsewhere on the board
/MCU/LORA_MISO: U11.16 (MISO); also elsewhere on the board
/MCU/LORA_MOSI: U11.17 (MOSI); also elsewhere on the board
/MCU/LORA_NRST: U11.15 (NRST); also elsewhere on the board
/MCU/LORA_RXEN: U11.6 (RXEN); also elsewhere on the board
/MCU/LORA_SCK: U11.18 (SCK); also elsewhere on the board
/MCU/RESET_GPS: U9.18 (~RESET); also elsewhere on the board
/MCU/RX_GPS: U9.14 (RXD); also elsewhere on the board
/MCU/TIMER_GPS: U9.7 (TIMEPULSE); also elsewhere on the board
/MCU/TX_GPS: U9.13 (TXD); also elsewhere on the board
/RF/VCC_GPS: C27.1, C28.1, FB2.2, U9.2 (VCC_IO), U9.3 (V_BCKP), U9.17 (VCC)
GND: C27.2, C28.2, C30.2, C31.2, C32.2, U9.1 (GND), U9.4 (GND), U9.5 (GND), U9.6 (GND), U9.10 (GND), U9.11 (GND), U9.15 (GND), U9.16 (GND), U9.20 (GND), U11.1 (GND), U11.2 (GND), U11.3 (GND), U11.4 (GND), U11.5 (GND), U11.11 (GND), U11.12 (GND), U11.20 (GND), U11.22 (GND); also elsewhere on the board
unnamed: TP6.1 (1_1), U9.8 (~SAFEBOOT)
unnamed: U11.7 (TXEN), U11.8 (DIO2)

Notes on the sheet:
LoRa
GPS

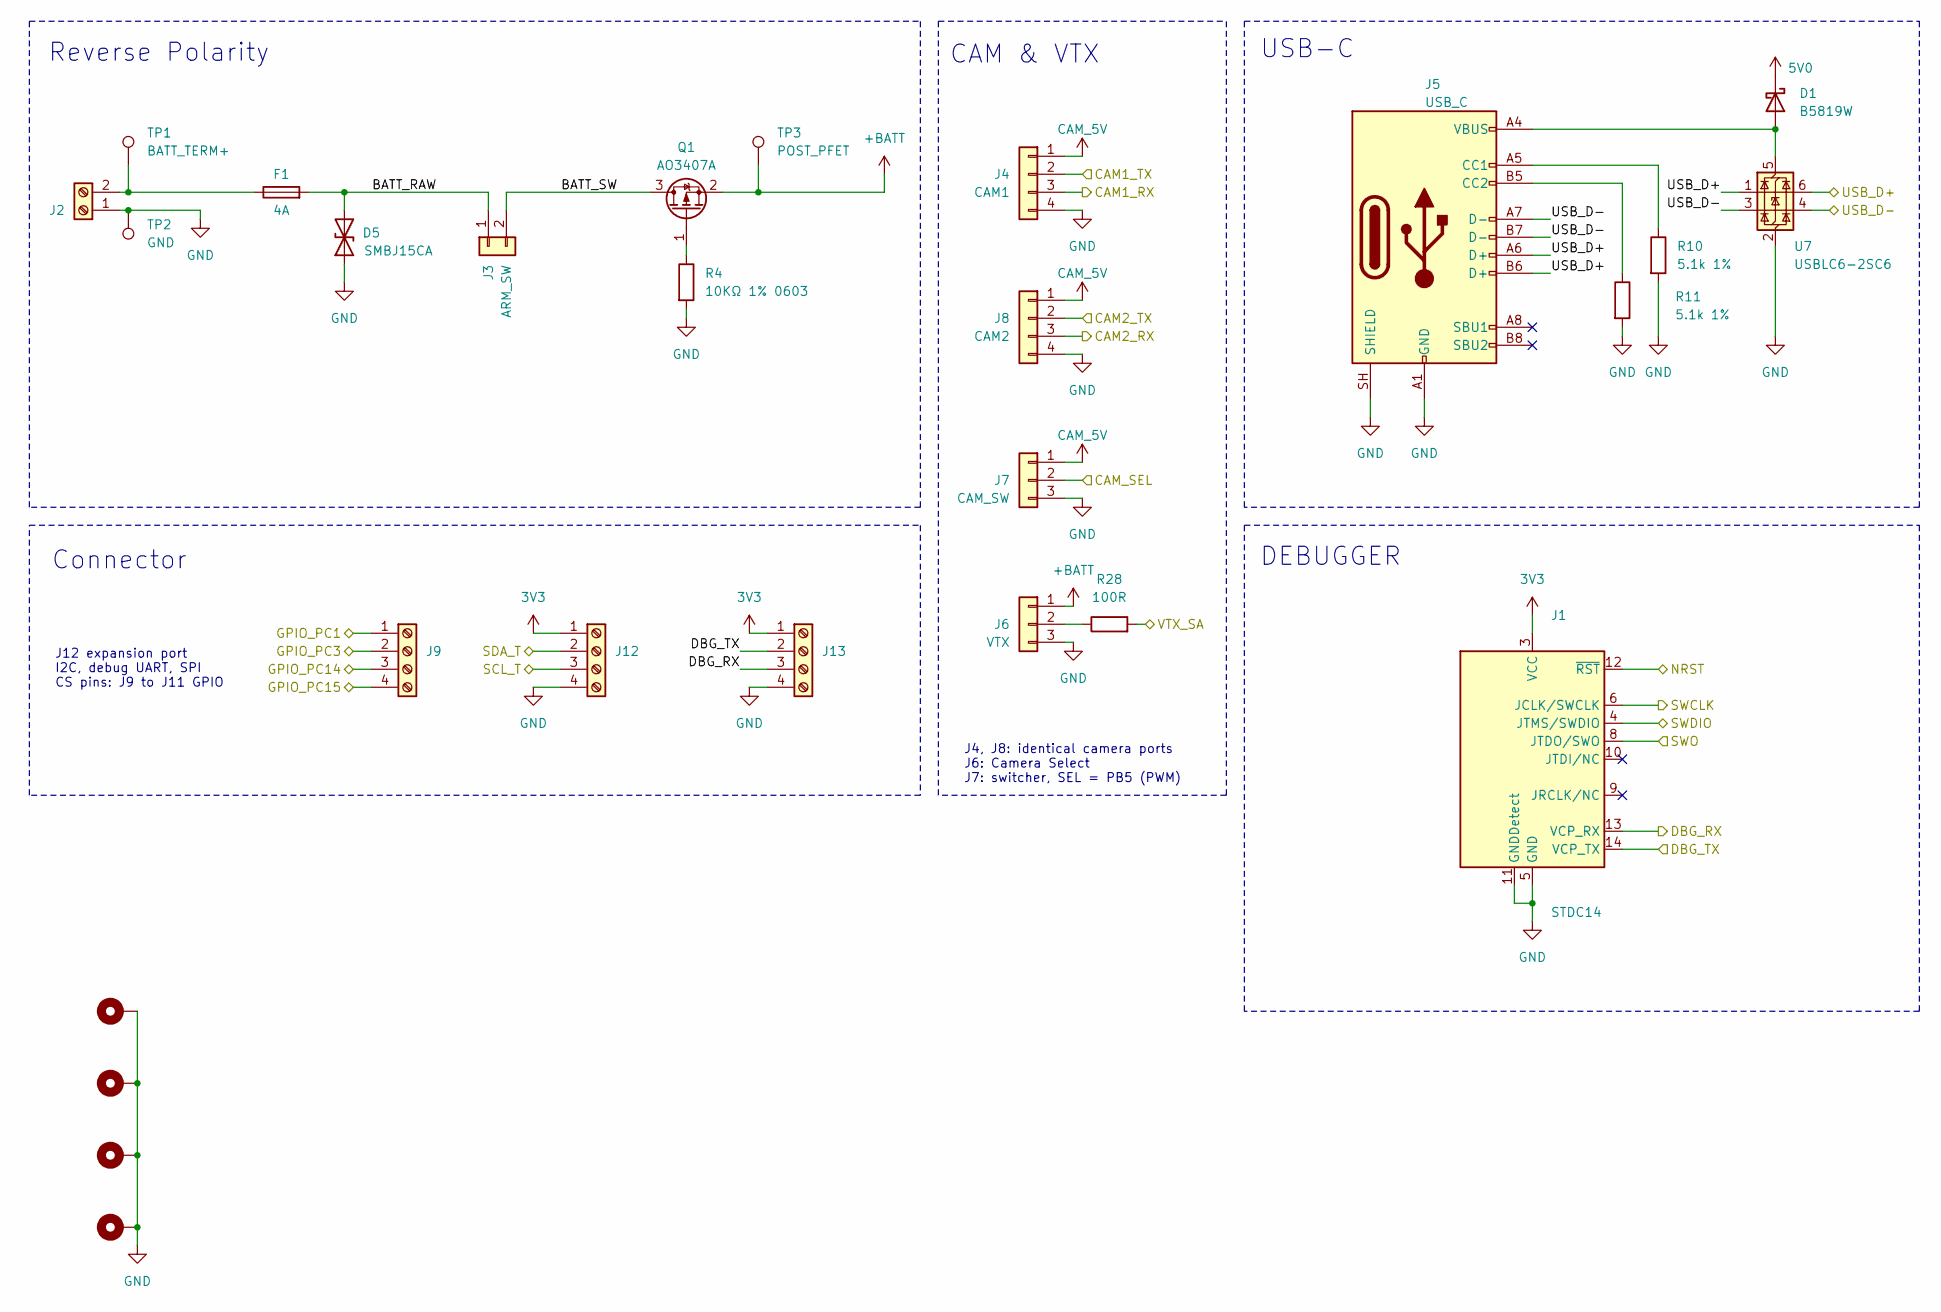
[picture p13: schematic CONNECTORS.kicad_sch, Connectors: Battery, Arming, Debug, Camera, USB-C]

Parts:
D1: B5819W; D_SOD-123
D5: SMBJ15CA; D_SMB
F1: 4A; Fuse_Littelfuse-NANO2-451_453; MPN 0451004.MRL
H2, H3, H4, H5: MountingHole_Pad; MountingHole_3.2mm_M3_Pad
J1: STDC14; PinHeader_2x07_P1.27mm_Vertical_SMD
J2: BATT; JST_XH_B2B-XH-A_1x02_P2.50mm_Vertical
J3: ARM_SW; JST_XH_B2B-XH-A_1x02_P2.50mm_Vertical
J4: CAM1; JST_PH_B4B-PH-K_1x04_P2.00mm_Vertical
J5: USB_C; USB_C_Receptacle_HRO_TYPE-C-31-M-12
J6: VTX; JST_XH_B3B-XH-A_1x03_P2.50mm_Vertical
J7: CAM_SW; JST_PH_B3B-PH-K_1x03_P2.00mm_Vertical
J8: CAM2; JST_PH_B4B-PH-K_1x04_P2.00mm_Vertical
J9, J12, J13: Screw_Terminal_01x04; TerminalBlock_Phoenix_PT-1,5-4-3.5-H_1x04_P3.50mm_Horizontal
Q1: AO3407A; SOT-23
R4: 10KΩ 1% 0603; R_0603_1608Metric_Pad0.98x0.95mm_HandSolder
R10, R11: 5.1k 1%; R_0603_1608Metric_Pad0.98x0.95mm_HandSolder
R28: 100R; R_0603_1608Metric_Pad0.98x0.95mm_HandSolder
TP1: BATT_TERM+; TestPoint_Pad_D1.5mm
TP2: GND; TestPoint_Pad_D1.5mm
TP3: POST_PFET; TestPoint_Pad_D1.5mm
U7: USBLC6-2SC6; SOT-23-6

Connections:
3V3: J1.3 (VCC), J12.1, J13.1; also elsewhere on the board
5V0: D1.1 (K); also elsewhere on the board
+BATT: J6.1, Q1.2 (S), TP3.1 (1_1); also elsewhere on the board
/CONNECTORS/BATT_RAW: D5.2 (A2), F1.2, J3.1
/CONNECTORS/BATT_SW: J3.2, Q1.3 (D)
/CONNECTORS/CAM1_RX: J4.3; also elsewhere on the board
/CONNECTORS/CAM1_TX: J4.2; also elsewhere on the board
/CONNECTORS/CAM2_RX: J8.3; also elsewhere on the board
/CONNECTORS/CAM2_TX: J8.2; also elsewhere on the board
/CONNECTORS/CAM_SEL: J7.2; also elsewhere on the board
/CONNECTORS/DBG_RX: J1.13 (VCP_RX), J13.3; also elsewhere on the board
/CONNECTORS/DBG_TX: J1.14 (VCP_TX), J13.2; also elsewhere on the board
/CONNECTORS/GPIO_PC1: J9.1; also elsewhere on the board
/CONNECTORS/GPIO_PC3: J9.2; also elsewhere on the board
/CONNECTORS/GPIO_PC14: J9.3; also elsewhere on the board
/CONNECTORS/GPIO_PC15: J9.4; also elsewhere on the board
/CONNECTORS/NRST: J1.12 (~RST); also elsewhere on the board
/CONNECTORS/SWCLK: J1.6 (JCLK/SWCLK); also elsewhere on the board
/CONNECTORS/SWDIO: J1.4 (JTMS/SWDIO); also elsewhere on the board
/CONNECTORS/SWO: J1.8 (JTDO/SWO); also elsewhere on the board
/CONNECTORS/USB_D+: J5.A6 (D+), J5.B6 (D+), U7.1 (I/O1), U7.6 (I/O1); also elsewhere on the board
/CONNECTORS/USB_D-: J5.A7 (D-), J5.B7 (D-), U7.3 (I/O2), U7.4 (I/O2); also elsewhere on the board
/CONNECTORS/VTX_SA: R28.2; also elsewhere on the board
/SCL_T: J12.3; also elsewhere on the board
/SDA_T: J12.2; also elsewhere on the board
CAM_5V: J4.1, J7.1, J8.1; also elsewhere on the board
GND: D5.1 (A1), H2.1 (1_1), H3.1 (1_1), H4.1 (1_1), H5.1 (1_1), J1.5 (GND), J1.7 (GND), J1.11 (GNDDetect), J2.1, J4.4, J5.A1 (GND), J5.A12 (GND), J5.B1 (GND), J5.B12 (GND), J5.SH (SHIELD), J6.3, J7.3, J8.4, J12.4, J13.4, R4.2, R10.2, R11.2, TP2.1 (1_1), U7.2 (GND); also elsewhere on the board
unnamed: D1.2 (A), J5.A4 (VBUS), J5.A9 (VBUS), J5.B4 (VBUS), J5.B9 (VBUS), U7.5 (VBUS)
unnamed: F1.1, J2.2, TP1.1 (1_1)
unnamed: J5.A5 (CC1), R10.1
unnamed: J5.B5 (CC2), R11.1
unnamed: J6.2, R28.1
unnamed: Q1.1 (G), R4.1

Notes on the sheet:
USB-C
Reverse Polarity
CAM & VTX
DEBUGGER
Connector
J12 expansion port I2C, debug UART, SPI CS pins: J9 to J11 GPIO
J4, J8: identical camera ports J6: Camera Select J7: switcher, SEL = PB5 (PWM)

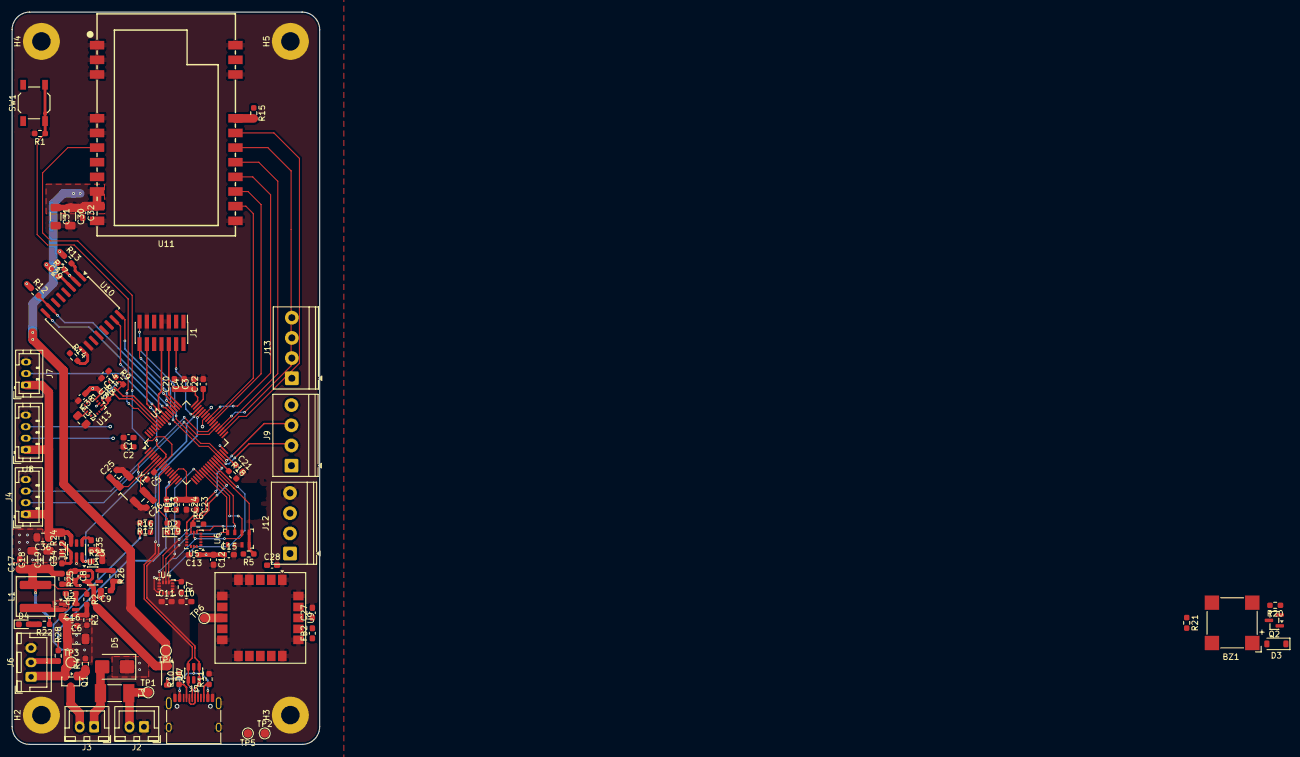
[picture p14: board UNCC_ROCKETRY_PAYLOAD_FALL_2026.kicad_pcb from above]

Board: 4 copper layers, 53.3 x 127.0 mm, 114 parts (0 on the bottom side), 85 nets.
