MalekAlbdoor/UNCC_ROCKETRY_PAYLOAD_FALL_2026/(commit log)

2026-10-21 Initial project: schematic sheets and parts list
    [CAM.kicad_sch, CONNECTORS.kicad_sch, FLASH.kicad_sch, MCU.kicad_sch, POWER.kicad_sch, RADIO.kicad_sch, SENSORS.kicad_sch, UNCC_ROCKETRY_PAYLOAD_FALL_2026.kicad_pcb]
2026-10-21 added micro and 3 sensors and connectors with USB
    [CONNECTORS.kicad_sch, MCU.kicad_sch, POWER.kicad_sch, SENSORS.kicad_sch, UNCC_ROCKETRY_PAYLOAD_FALL_2026.kicad_sch]
2026-10-21 cleaned up Schematic
    [UNCC_ROCKETRY_PAYLOAD_FALL_2026.kicad_sch]
2026-10-21 added GPS and Temp/Humid sensor
    [MCU.kicad_sch, SENSORS.kicad_sch, UNCC_ROCKETRY_PAYLOAD_FALL_2026.kicad_sch]
2026-10-21 Add README and RF sheet
    [RF.kicad_sch]
2026-10-21 added schematic PDF
2026-10-21 added Buzzer, status LEDs
    [CONNECTORS.kicad_sch, FLASH.kicad_sch, MCU.kicad_sch, POWER.kicad_sch, RF.kicad_sch, SENSORS.kicad_sch, UNCC_ROCKETRY_PAYLOAD_FALL_2026.kicad_sch]
2026-10-24 Battery protection, camera switch, 64MB flash, ERC clean
    - Fuse + TVS on battery input, camera load switch (TPS22917)
    - Flash to W25Q512JVFIQ (SOIC-16), hand-solder passive footprints
    - Power LED, title blocks, U5 footprint, PWR/NC flags (0 ERC)
    - Regenerated schematic PDF
    [CONNECTORS.kicad_sch, FLASH.kicad_sch, MCU.kicad_sch, POWER.kicad_sch, RF.kicad_sch, SENSORS.kicad_sch, UNCC_ROCKETRY_PAYLOAD_FALL_2026.kicad_sch]
2026-10-24 README: point to Schematic.pdf
2026-10-26 wrote firmware for both the base station and payload prototypes for testing in platformio, also made a browser dashboard to read live telemetry
2026-10-26 updated both firmwares to add battery info and also updated the dashboard
2026-10-26 updated firmware to fix altitude bug also added mangometer support, updated GUI to have slider for time
    [CONNECTORS.kicad_sch, SENSORS.kicad_sch, UNCC_ROCKETRY_PAYLOAD_FALL_2026.kicad_sch]
2026-10-29 started layout
    [UNCC_ROCKETRY_PAYLOAD_FALL_2026.kicad_pcb, UNCC_ROCKETRY_PAYLOAD_FALL_2026.kicad_sch]
2026-10-29 layed out components, no routing
    [CONNECTORS.kicad_sch, UNCC_ROCKETRY_PAYLOAD_FALL_2026.kicad_pcb, UNCC_ROCKETRY_PAYLOAD_FALL_2026.kicad_sch]
2026-10-29 more layout progress
    [UNCC_ROCKETRY_PAYLOAD_FALL_2026.kicad_pcb]
2026-11-02 added second connector for another camera also added a connector for a 5.8 GHz video transmitter and a switcher to switch between the two
    [CONNECTORS.kicad_sch, MCU.kicad_sch, UNCC_ROCKETRY_PAYLOAD_FALL_2026.kicad_pcb, UNCC_ROCKETRY_PAYLOAD_FALL_2026.kicad_sch]
2026-11-02 added more PHX terminals for GPIO and external boards
    [CONNECTORS.kicad_sch, UNCC_ROCKETRY_PAYLOAD_FALL_2026.kicad_pcb]
2026-11-02 Credit Charlotte Rocketry Club in license, update schematic PDF
    License stays CC BY-NC 4.0. Attribution now names both Malek Albdoor and
    the Charlotte Rocketry Club at UNC Charlotte, with a suggested credit line
    in the README and a notice above the license text.
2026-11-12 did major work on component placement, just need to place sensors and conenctors then routing can begin
    [CONNECTORS.kicad_sch, MCU.kicad_sch, POWER.kicad_sch, UNCC_ROCKETRY_PAYLOAD_FALL_2026.kicad_pcb, UNCC_ROCKETRY_PAYLOAD_FALL_2026.kicad_sch]
2026-11-12 moved some components around
    [UNCC_ROCKETRY_PAYLOAD_FALL_2026.kicad_pcb]
2026-11-12 did lots of routing work. 75% done
    [CONNECTORS.kicad_sch, MCU.kicad_sch, UNCC_ROCKETRY_PAYLOAD_FALL_2026.kicad_pcb, UNCC_ROCKETRY_PAYLOAD_FALL_2026.kicad_sch]
2026-11-12 routed connector
    [CONNECTORS.kicad_sch, UNCC_ROCKETRY_PAYLOAD_FALL_2026.kicad_pcb]
2026-11-13 routed IMU and moved it to middle of board
    [UNCC_ROCKETRY_PAYLOAD_FALL_2026.kicad_pcb]
